technorama-ssc/you-decide/02 system/README.md

---
download: System Build Kit
slug: 999_system
download_slug: 999_sample_wall_connectors
---

# SYSTEM

All exhibits are based on a modular system. We have developed a range of connection solutions for 3D printing. The system is also compatible with the ITEM D30 system and can be expanded.

Here you can find information and materials about the construction system used throughout the exhibition.

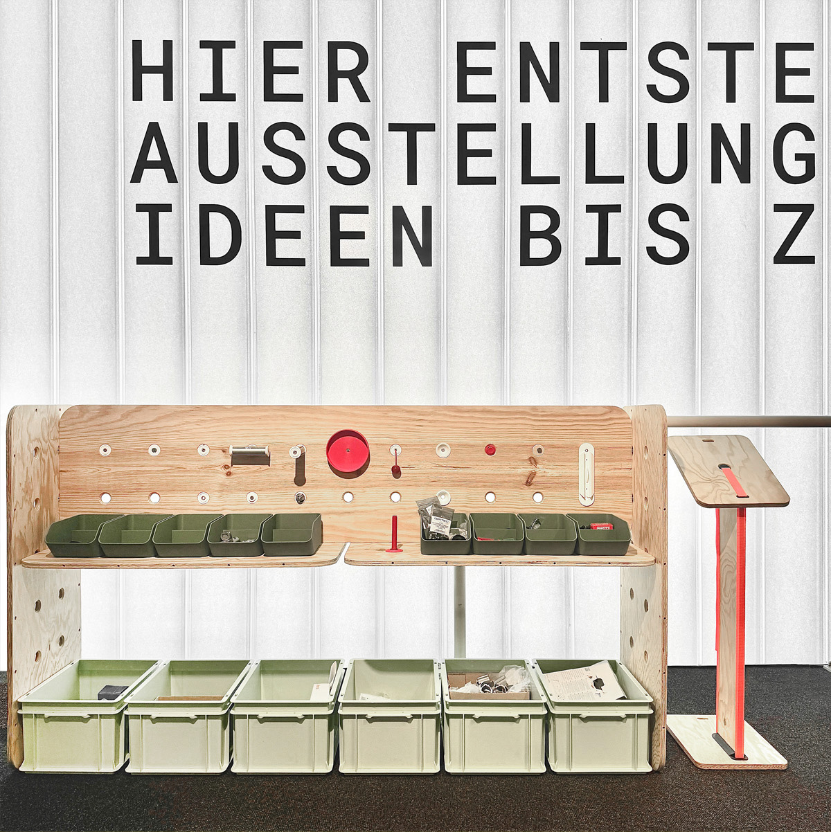
[picture p1: 02 system/999_system/04 media/You Decide_Sample Wall System Connectors .jpg]
SYSTEM


## Grid

The grid system is based on a modular design with a 157 mm grid and a 9 mm margin. The system panels are milled from 19 mm pine and feature Ø30 mm grid holes. They are compatible with the item D30 system for expansion.

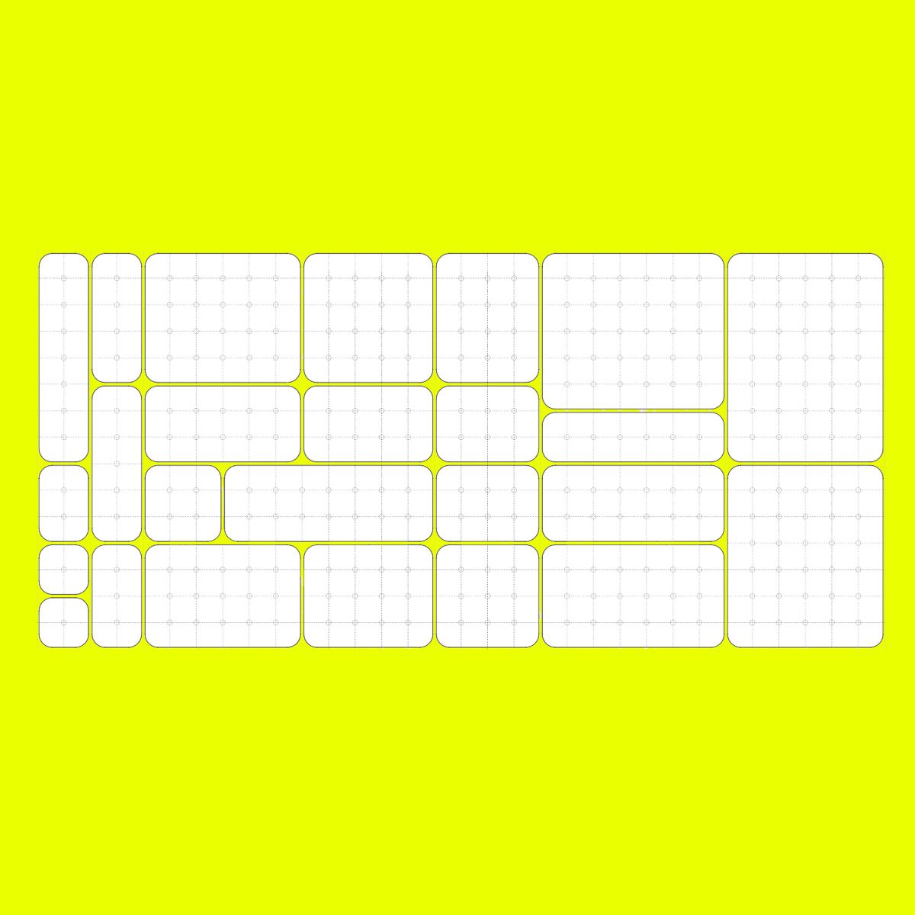
[picture p2: 02 system/999_system/04 media/You Decide_Grid System.jpg]
Grid


## Connectors

Main connector printed with: [Bambu Lab X1](https://eu.store.bambulab.com/de/products/pla-cf?id=43944001994971) <br>
INOX screw M6x35 mm available at: [Bossard](https://www.bossard.com/eshop/ch-de/schrauben/schrauben-mit-innenantrieb/senkschrauben-mit-innensechskant-ohne-schaft/p/2104/) <br>
M6 cross dowels type Q ⌀10x14 mm available at: [Rampa](https://www.rampa.com/eu/de/Onlineshop/Produkte/Quergewindebolzen/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)

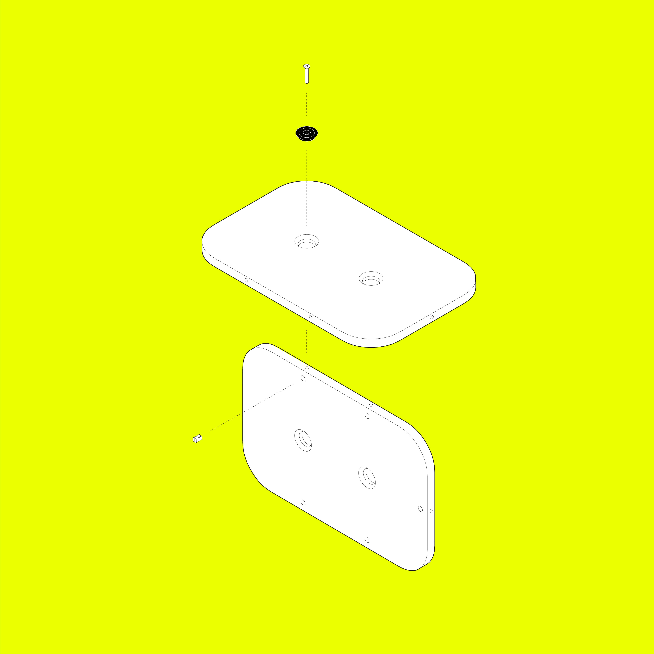
[picture p3: 02 system/999_system/04 media/You Decide_Main Connector_Technorama.jpg]
Connectors
