technorama-ssc/you-decide/you decide/hardware/README.md

# Hardware

Materials used for the exhibition labels and graphics:

- [Masking tape, writable, 15 mm x 20 m (Amazon)](https://www.amazon.de/dp/B09HZVJXY6)
- [Clairefontaine Trophée neon yellow paper, DIN A4 (papierdirekt.ch)](https://www.papierdirekt.ch/druckpapier/nach-format/druckpapiere-format-din-a3-297-x-420-mm/clairefontaine-troph-e-neon-din-a4-gelb.html)
