technorama-ssc/you-decide/01 exhibits/048_know yourself/README.md

---
id: "048"
download: Exhibit Build Kit
published: false
---

# know yourself

A vertical mirror, approximately 50 cm high and 90 cm wide, is placed on the floor against a wall. In front of it, a 5 CHF coin is glued to the floor.
When visitors bend down to pick up the coin, they realize that it is fixed in place and unexpectedly find themselves looking at their own reflection in the mirror.

## Findings

- Many visitors see the mirror before noticing the coin. 
- Visitors often smile or laugh when they realize the coin is glued to the floor. 
- Some visitors make repeated attempts to pick up the coin despite realizing it is fixed.
