technorama-ssc/you-decide/01 exhibits/000_do not press/README.md

---
id: "000"
download: Exhibit Build Kit
---

# Do not Press

A red button with the words “Do not press.” Behind it is a mechanism that you cannot see, but you can reach it. After pressing, a stuffed toy is destroyed.

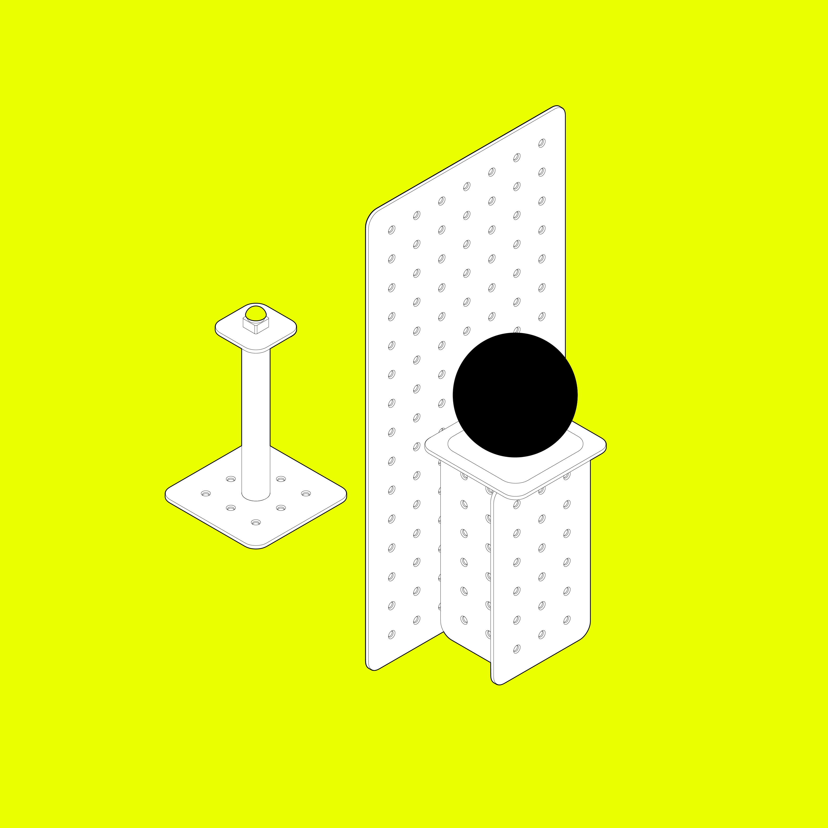
[picture p4: 01 exhibits/000_do not press/04 media/You Decide_Do not press_Technorama.jpg]
Do not Press


## Findings (draft)

...

## Libet Experiment (draft)

The brain “presses the button” before you believe you have made the decision.

In the Libet experiment, it was shown that the brain’s motor system begins preparing a movement before a person becomes consciously aware that they have decided to execute that movement immediately. The time gap is about 0.35 seconds, and the actual movement then occurs roughly another 0.2 seconds later.

[wikipedia.org/wiki/Libet-Experiment](https://de.wikipedia.org/wiki/Libet-Experiment)
