technorama-ssc/you-decide/01 exhibits/023_the coin/README.md

---
id: "023"
download: Exhibit Build Kit
---

# The Coin

Each week, we place a game coin in a jewelry case. Guests can choose whether to leave the coin or take it with them. If the coin remains until the end of the week, we donate CHF 50 to a charitable project – otherwise, we do not.

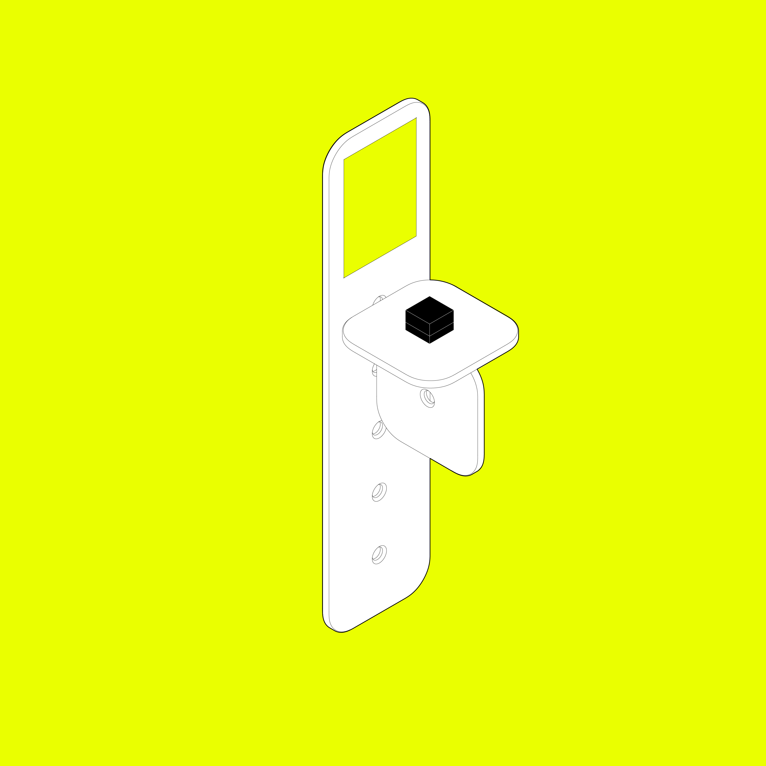
[picture p5: 01 exhibits/023_the coin/04 media/You Decide_The Coin_Technorama.jpg]
The Coin


## Findings

- The game coin usually is taken before the week is over.
- When the game coin is gone, a visitor will donate a real coin by placing it in the box.
- We collect the real coins for a charitable donation.
- We have discovered that whenever there is an empty box, visitors will again donate a real coin, some even hiding the coins under the velvet pad of the box.

## Konsequenzen (draft)

Das Exponat verbindet Fragen zur Entscheidungsfindung mit globaler Gesundheitspolitik. Tuberkulose zählt weltweit zu den häufigsten tödlichen Infektionskrankheiten. Jährlich sterben etwa 1,3 Millionen Menschen an der Erkrankung, hauptsächlich in Low-Income-Ländern (WHO-Daten 2024). Die Krankheit ist in vielen Fällen behandelbar, dennoch scheitert eine wirksame Bekämpfung oft an fehlendem Zugang zu Diagnostik, Medikamenten und stabilen Gesundheitssystemen.
50 Franken decken bereits die Kosten für Medikamente für mehrere Patientinnen und Patienten. Damit wird deutlich, wie konkrete finanzielle Beiträge unmittelbar in medizinische Versorgung übersetzt werden können. Aktuelle Daten und Berichte zu Tuberkulose bietet die World Health Organization (WHO) im jährlich erscheinenden „Global Tuberculosis Report“. 
Die Forschung zur Spendenpsychologie – etwa von den Nobelpreisträgern Abhijit V. Banerjee und Esther Duflo oder den Ökonomen Dean Karlan und Jacob Appel – hat gezeigt, dass auch relativ kleine Summen unter bestimmten Bedingungen eine messbare Wirkung entfalten können.

Literatur zur Einführung:
Ariely, Dan (2012): The Honest Truth About Dishonesty. Harper ; New York.
Banerjee, Abhijit V.; Duflo, Esther (2011): Poor Economics: A Radical Rethinking of the Way to Fight Global Poverty. PublicAffairs; New York.
Karlan, Dean; Appel, Jacob (2011): More Than Good Intentions: Improving the Ways the World's Poor Borrow, Save, Farm, Learn, and Stay Healthy. Dutton; New York.

Global Tuberculosis Report:
https://www.who.int/teams/global-tuberculosis-programme/tb-reports

## Moral (draft)

Philosophisch berührt das Exponat zentrale ethische Fragen der Verantwortung, des Unterlassens und der moralischen Pflicht. Wie weit reicht unsere Pflicht zu helfen? Und ist Unterlassen moralisch neutral oder bereits eine Entscheidung? Das Exponat macht damit ein klassisches Problem der Moralphilosophie sichtbar: Sind wir nur für das verantwortlich, was wir aktiv tun, oder auch für das, was wir bewusst nicht verhindern? In der Ethik wird beispielsweise diskutiert, ob Nicht-Handeln moralisch anders zu bewerten ist als aktives Handeln (Stichwort: „doing vs. allowing“). Ethische Diskussionen drehen sich auch um die Frage, ob Einzelne Vorteile geniessen, während andere die Last tragen.
Wichtige Beiträge zur ethischen Frage der Verantwortung, der Pflicht und des Spendens finden sich bei Peter Singer, insbesondere im Aufsatz „Famine, Affluence, and Morality“ sowie in seinem Buch „The Life You Can Save“. Singer argumentiert, dass Menschen moralisch verpflichtet sein könnten zu helfen, wenn sie dies ohne grossen eigenen Verlust tun können. Demgegenüber betonen andere Ansätze in der Ethik, etwa so genannte vertragstheoretische oder tugendethische Positionen, stärker die Rolle freiwilliger Solidarität und persönlicher Beziehungen bei moralischen Pflichten. Diese Ansätze sehen keine Pflicht zum Spenden.

Literatur zur Einführung:
Scanlon, Thomas M. (1998): What We Owe to Each Other. Harvard University Press; Cambridge.
Singer, Peter (1972): Famine, Affluence, and Morality. Philosophy and Public Affairs, 1(3): S. 229–243.
Singer, Peter (2009): The Life You Can Save. Random House; New York.

Überblick über moralische Dilemmata:
https://plato.stanford.edu/entries/moral-dilemmas/

Überblick über moralische Verantwortung:
https://plato.stanford.edu/entries/moral-responsibility/

## Partizipation (draft)

Das Exponat steht in der Tradition partizipativer und konzeptueller Kunst, bei der die Idee wichtiger ist als das materielle Objekt. Vergleichbare Ansätze finden sich bei Yoko Ono (Instructions for Paintings, 1960er Jahre) oder Felix Gonzalez-Torres (Arbeiten mit frei entnehmbaren Objekten, 1990er Jahre). In der Konzeptkunst wird das Publikum häufig Teil des Werks. Das Kunstwerk entsteht nicht allein durch ein Objekt, sondern durch eine gedankliche Anweisung und durch die Handlung der Betrachtenden.
Das Konzept des Exponats greift ausserdem auf Ideen der Entscheidungstheorie zurück, insbesondere die Nudge-Theorie von Richard Thaler und Cass Sunstein, bei der kleine Anreize Verhalten lenken sollen. Ein „Nudge“ verändert dabei nicht die Wahlmöglichkeiten selbst, sondern gestaltet die Entscheidungssituation so, dass ein bestimmtes Verhalten wahrscheinlicher wird.

Literatur zur Einführung:
Bishop, Claire (2012): Artificial Hells. Participatory Art and the Politics of Spectatorship. Verso; London u. New York.
Godfrey, Tony (1998): Conceptual Art. Phaidon; London.
Thaler, Richard H.; Sunstein, Cass R. (2008): Nudge: Improving Decisions about Health, Wealth, and Happiness. Yale University Press; New Haven.

Überblick zur Konzeptkunst:
https://www.tate.org.uk/art/art-terms/c/conceptual-art

Überblick über die Nudge Theory:
https://thedecisionlab.com/reference-guide/psychology/nudge-theory

## Verhaltensökonomie (draft)

Die Entscheidungssituation mit der Münze ähnelt klassischen Experimenten der Verhaltensökonomie wie dem „Public Goods Game“ oder dem „Prisoner’s Dilemma“. Diese Experimente untersuchen, unter welchen Bedingungen Menschen kooperieren oder egoistisch handeln. Das „Public Goods Game“ ist ein Experiment, bei dem mehrere Personen Geld in einen gemeinsamen Topf einzahlen können. Das Geld wird vermehrt und anschliessend gleichmäßig verteilt – auch an diejenigen, die nichts eingezahlt haben. Das „Prisoner’s Dilemma“ ist ein Gedankenexperiment aus der Spieltheorie: Zwei Personen können kooperieren oder sich gegenseitig verraten. Für jede Person ist Verrat aus Sicht des Eigeninteresses vorteilhaft, doch wenn beide verraten, stehen am Ende beide schlechter da, als wenn sie kooperiert hätten.
Wichtige Beiträge stammen von Ernst Fehr, Simon Gächter und Klaus Schmidt zur Kooperation und Bestrafung in Gruppen. Eine allgemeinverständliche Einführung bietet Daniel Kahneman in „Thinking, Fast and Slow“. Kahnemann zeigt, dass Menschen nicht rein rational im Sinne des Eigennutzes handeln, sondern stark von Fairnessvorstellungen, sozialen Normen und intuitiven Urteilen geleitet werden. Kooperation entsteht häufig dann, wenn Vertrauen, Gegenseitigkeit und die Erwartung sozialer Anerkennung eine Rolle spielen.

Literatur zur Einführung:
Fehr, Ernst; Gächter, Simon (2000): Cooperation and Punishment in Public Goods Experiments. American Economic Review, 90(4): S. 980–994.
Fehr, Ernst; Schmidt, Klaus (1999): A Theory of Fairness, Competition, and Cooperation. The Quarterly Journal of Economics, 114(3): S. 817–868.
Kahneman, Daniel (2011): Thinking, Fast and Slow. Farrar, Straus and Giroux; New York.

Überblick über das Prisoner’s Dilemma:
https://plato.stanford.edu/entries/prisoner-dilemma/
