technorama-ssc/you-decide/01 exhibits/041_bim bam bum/README.md

---
id: "041"
download: Exhibit Build Kit
---

# Bim Bam Bum

A bicycle pump stands in the room. Above it floats a red balloon. The balloon cannot burst. You pump towards a goal that is actually pointless – but you don’t know it.

How long will you keep pumping?

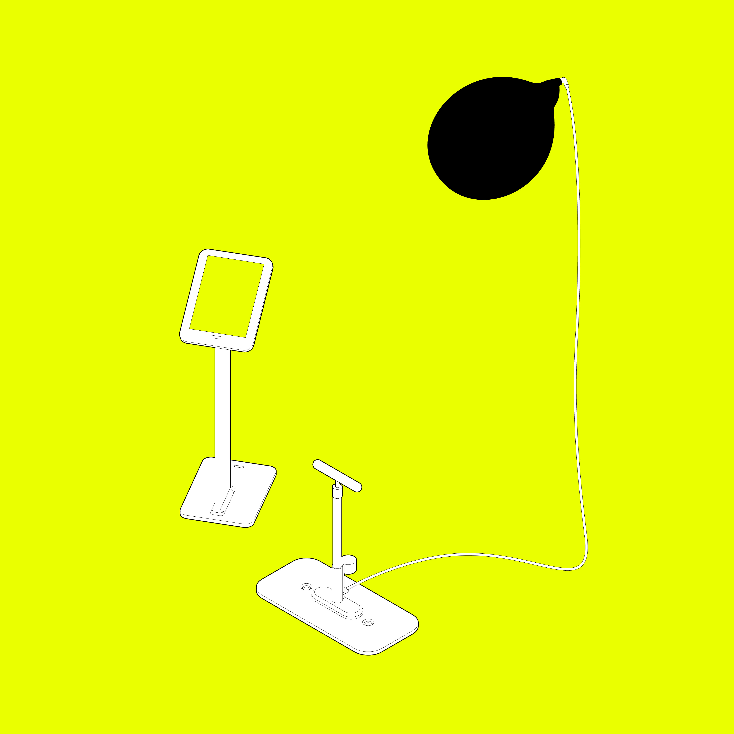
[picture p6: 01 exhibits/041_bim bam bum/04 media/You Decide_Bim Bam Bum_Technorama.jpg]
Bim Bam Bum


## Findings (draft)

...

## Libet Experiment (draft)

The brain “presses the button” before you believe you have made the decision.

In the Libet experiment, it was shown that the brain’s motor system begins preparing a movement before a person becomes consciously aware that they have decided to execute that movement immediately. The time gap is about 0.35 seconds, and the actual movement then occurs roughly another 0.2 seconds later.

[wikipedia.org/wiki/Libet-Experiment](https://de.wikipedia.org/wiki/Libet-Experiment)
