technorama-ssc/you-decide/01 exhibits/029_the tower/README.md

---
id: "029"
---

# the tower

On a table there are wooden cubes with magnets and screws. At the four corners there are supports with cords that allow 4 players to cooperate in building a tower.

## Findings

- Visitors enjoy playing and cooperate to build a tower.
- It can be frustrating when the cubes fall.
