technorama-ssc/you-decide/01 exhibits/023_the coin/04 media/Exhibit graphics_023_the coin.pdf

# Die Münze

# Rette ein Leben

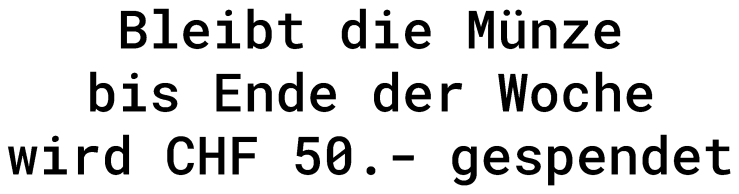
[picture p8: figure]
Bleibt die Münze bis Ende der Woche; wird CHF 50.; - gespendet

1,5 Mio. Menschen sterben jährlich weltweit an Tuberkulose (TB) | – das
entspricht etwa der Bevölkerung des Kanton Zürich. | Damit ist TB
die tödlichste Infektionskrankheit weltweit. Eine Spende von CHF 50. | -
ermöglicht Ärzte ohne Grenzen (MSF) die Behandlung einer Person
mit Tuberkulose | – eine Chance auf Heilung und Leben.

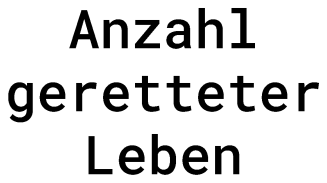
[picture p9: figure]
Anzahl geretteter Leben

1 Jahr / Kein Leben gerettet

31.08 - 06.09 2026 / Kein Leben gerettet
