technorama-ssc/you-decide/00 you decide/README.md

---
download: Exhibition Graphics Kit
slug: 998_exhibition
---

# YOU DECIDE

An exhibition about decisions—and how to save the world.

With over 20,000 decisions a day, we shape our future. Left or right, bike or bus, red or green gummy bear – do you know how you decide? In “You Decide”, you can experience yourself making decisions. How do you make decisions? What influences you? When do you take mental shortcuts?

This is the open-source platform for the “You Decide” exhibition. The exhibition—and this website—will never be finished—they keep changing with you.

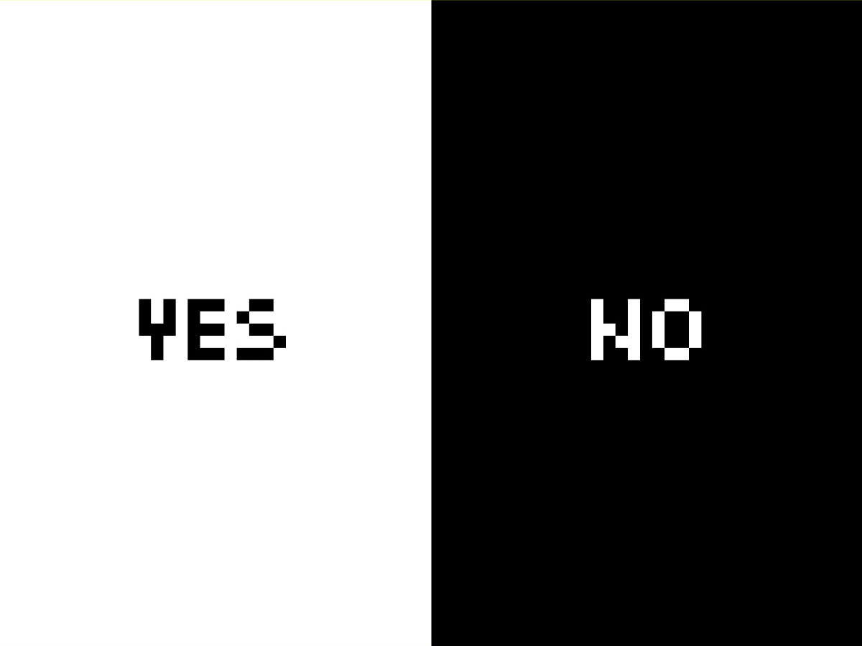
[picture p10: 00 you decide/998_exhibition/04 media/You Decide_Yes or No.jpg]
YOU DECIDE
