technorama-ssc/you-decide/01 exhibits/README.md

---
sections: "*"
---

# EXHIBITS

We continuously develop new ideas. In our exhibition, we test prototypes and keep improving them. Technorama guests are the test subjects. We want to prompt the question "How do I make decisions?"

Here we present a selection of our most advanced exhibits. You can download the parts lists and information for each exhibit here, rebuild them, or improve them.

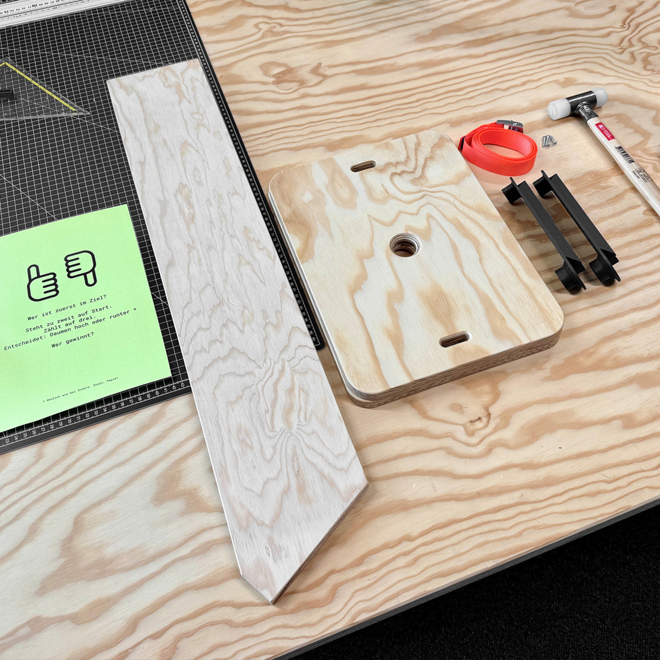
[picture p11: 01 exhibits/_media/youdecide_system_text stand.jpg]
EXHIBITS
