technorama-ssc/you-decide/01 exhibits/004_who's first on top/README.md

---
id: "004"
download: Exhibit Build Kit
---

# Who's First On Top

A two-player game that lets you experience the Prisoner’s Dilemma firsthand. Simple enough to become a break-time game for every school.

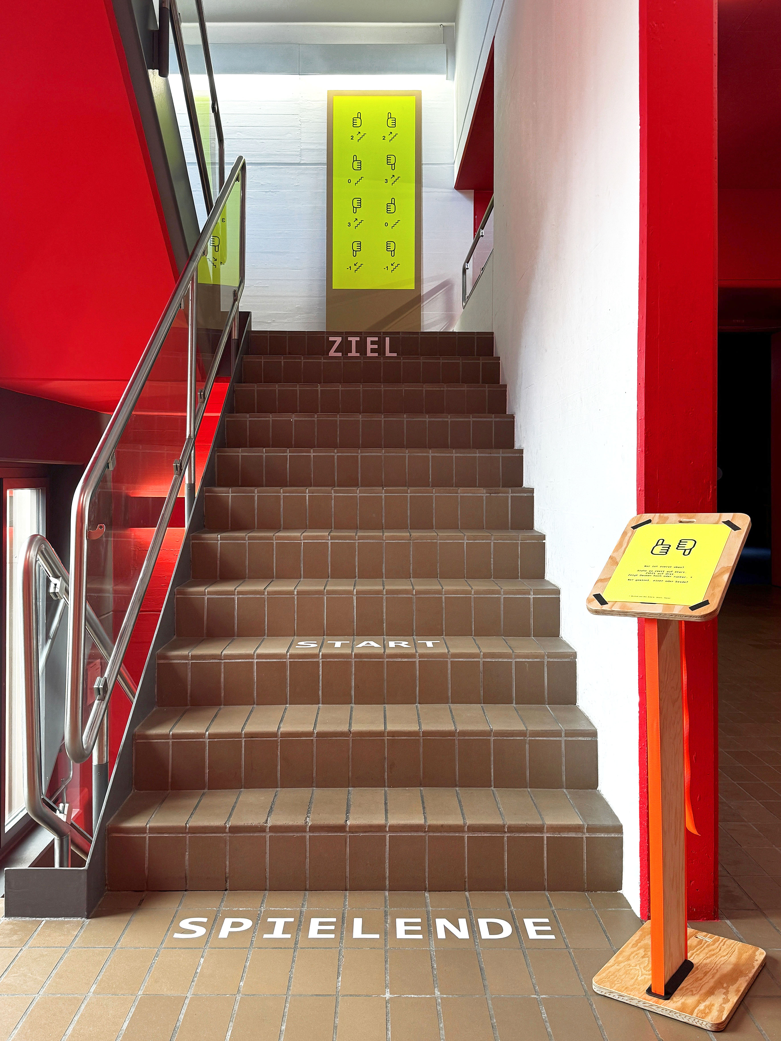
[picture p12: 01 exhibits/004_who's first on top/04 media/You Decide_Hwo's first on top_Technorama.jpg]
Who's First On Top


## Findings (draft)

...

## Background

The Prisoner’s Dilemma shows just how difficult decisions can become when personal interest and the common good come into conflict. What seems rational for one person can lead to a worse outcome for everyone. This paradox is what makes the dilemma so fascinating — and invites us to look at many everyday decisions and conflicts with others from a different perspective.

Film: [Game theorie](https://www.youtube.com/watch?v=mScpHTIi-kM)
