technorama-ssc/you-decide/01 exhibits/001_click click click/README.md

---
id: "001"
download: Exhibit Build Kit
---

# Click Click Click

Information to follow...

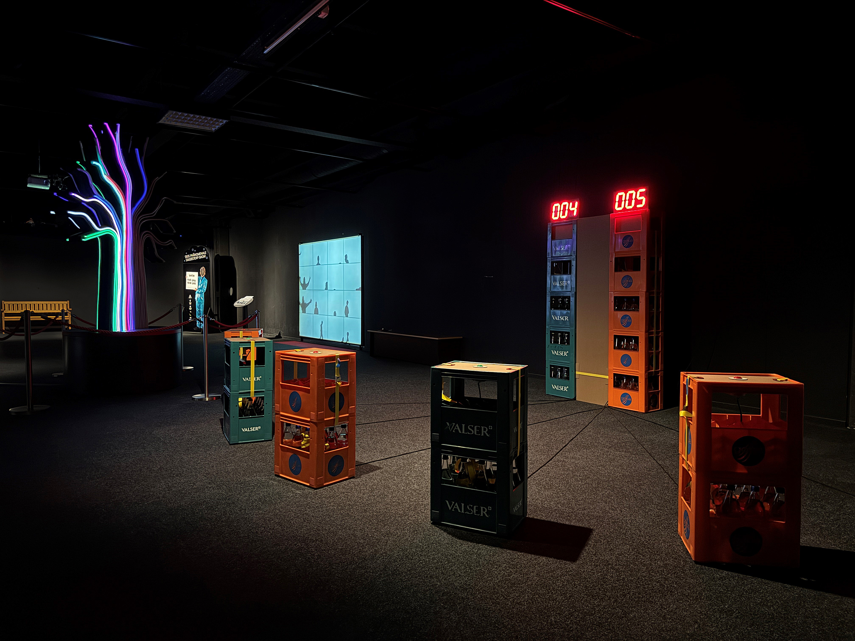
[picture p13: 01 exhibits/001_click click click/04 media/You Decide_Click Click Click_Technorama.jpg]
Click Click Click
