technorama-ssc/you-decide/01 exhibits/033_the circle/README.md

---
id: "033"
download: Exhibit Build Kit
---

# The Circle

The visitors decide together who may enter the circle. Once someone is inside, the rule is:

“No going back – convince another person to enter the circle, then you may leave.”

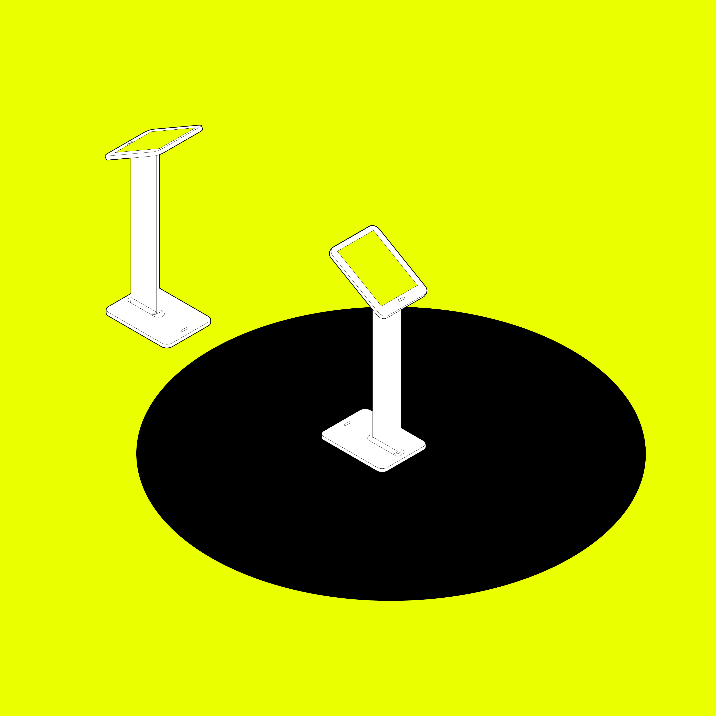
[picture p14: 01 exhibits/033_the circle/04 media/You Decide_The Circle_Technorama.jpg]
The Circle


## Findings (draft)

...

## Libet Experiment (draft)

The brain “presses the button” before you believe you have made the decision.

In the Libet experiment, it was shown that the brain’s motor system begins preparing a movement before a person becomes consciously aware that they have decided to execute that movement immediately. The time gap is about 0.35 seconds, and the actual movement then occurs roughly another 0.2 seconds later.

[wikipedia.org/wiki/Libet-Experiment](https://de.wikipedia.org/wiki/Libet-Experiment)
