technorama-ssc/you-decide/00 you decide/998_exhibition/01 docs/Graphic template A4.pptx

WIESO?

Deine Wahl
interesiert uns

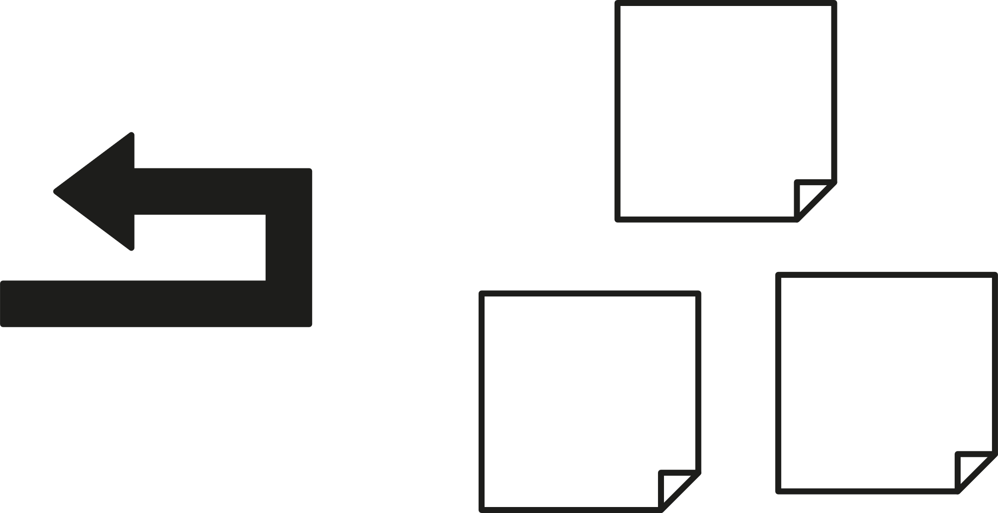
[picture p15: figure]

## Slide 2

Welche Schüssel gefällt dir besser?

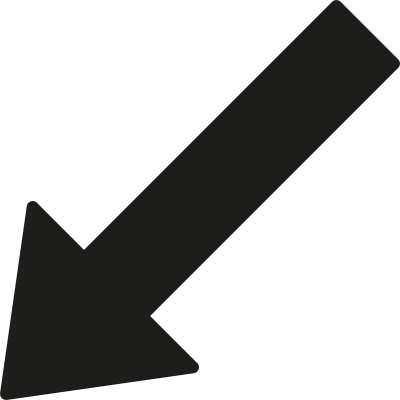
[picture p16: figure]
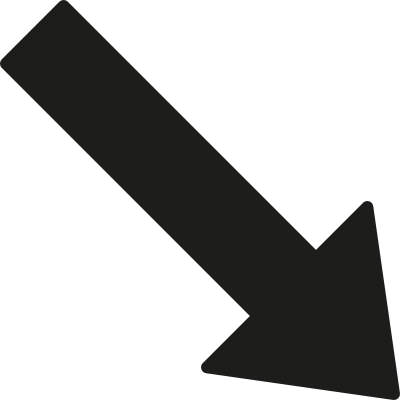
[picture p17: figure]

## Slide 3

Nicht
DrückeN

Gestalte dein Eigenes Plakat.
Rettet das Plüschtir!
