technorama-ssc/you-decide/01 exhibits/004_who's first on top/04 media/Exhibit graphics_004_who's first on top.pdf

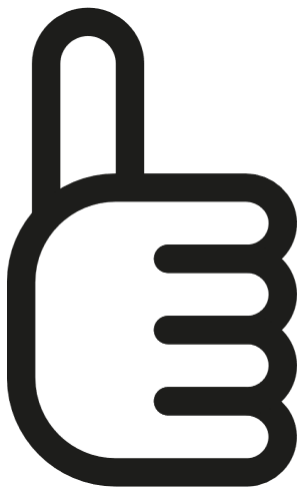
[picture p18: figure]
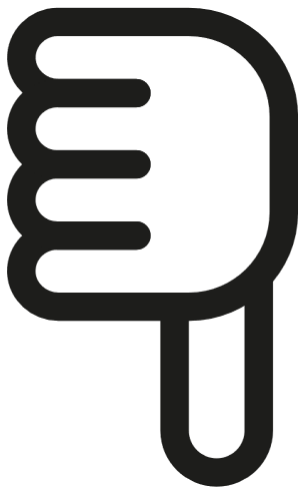
[picture p19: figure]

Wer ist zuerst oben?

* Ähnlich wie bei Schere, Stein, Papier | 160g

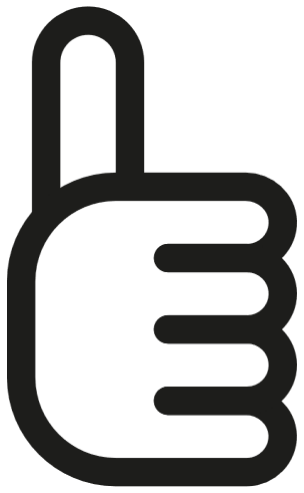
[picture p20: figure]
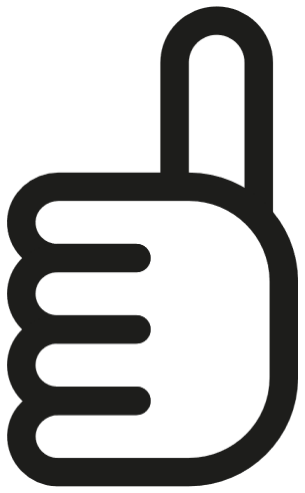
[picture p21: figure]
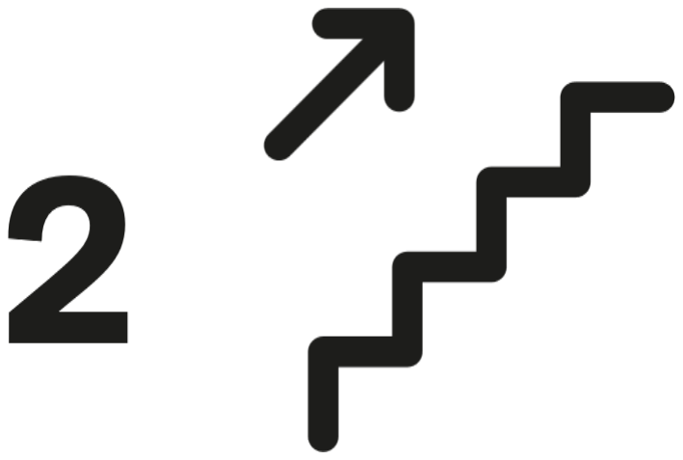
[picture p22: figure]
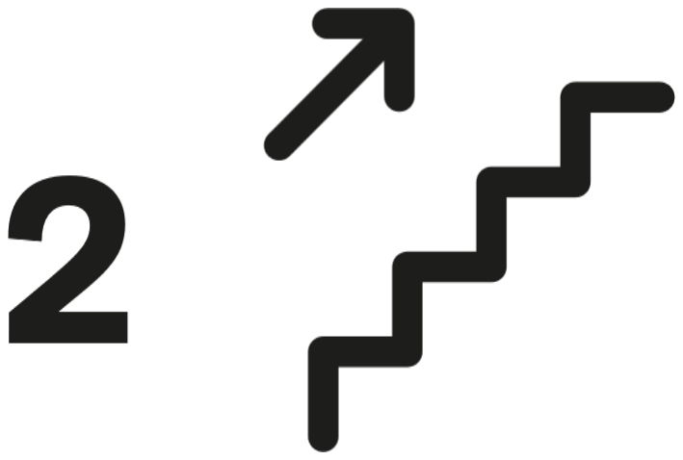
[picture p23: figure]

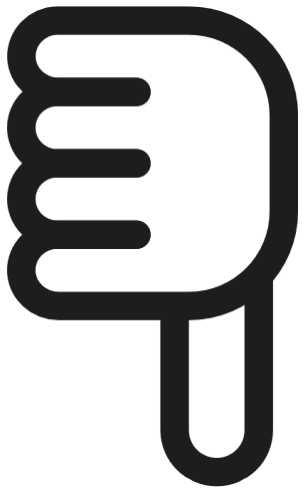
[picture p24: figure]
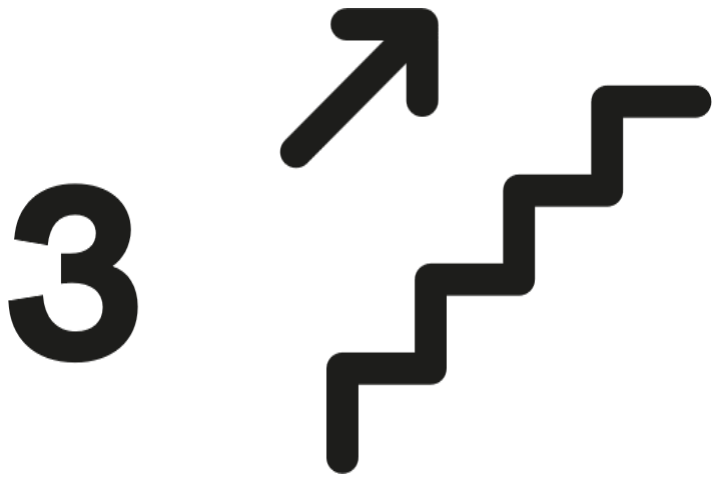
[picture p25: figure]
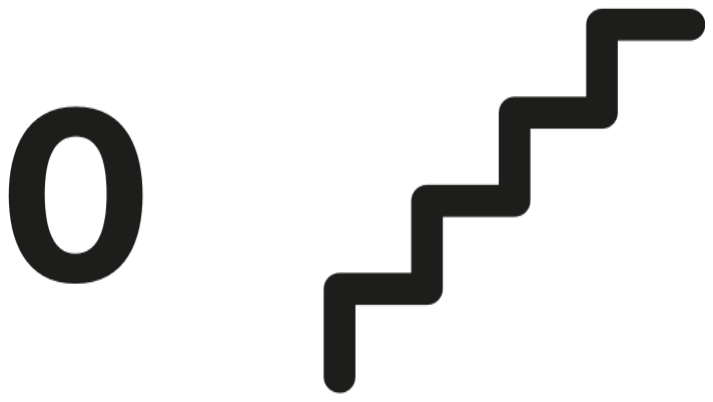
[picture p26: figure]

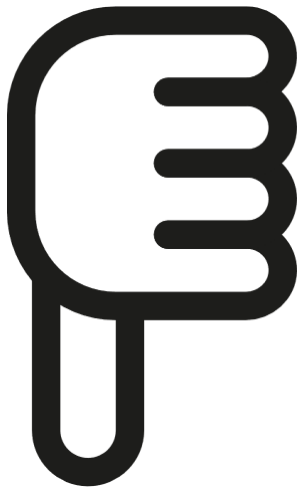
[picture p27: figure]
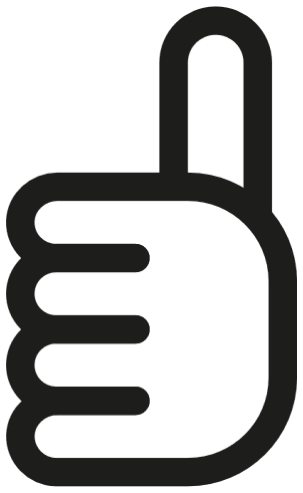
[picture p28: figure]
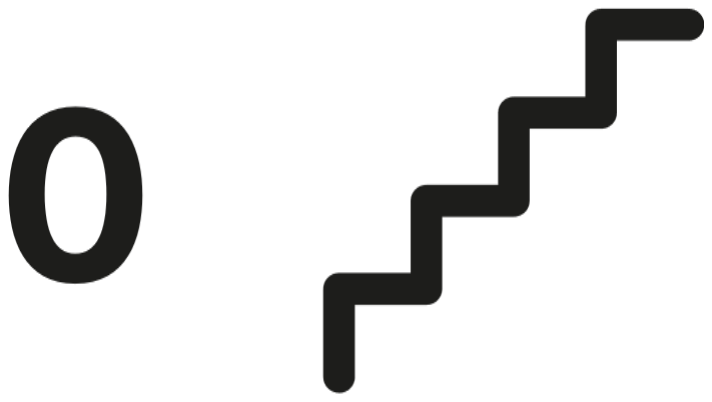
[picture p29: figure]

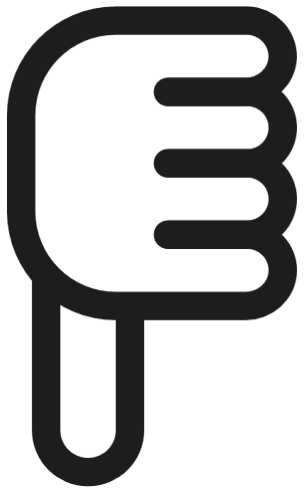
[picture p30: figure]
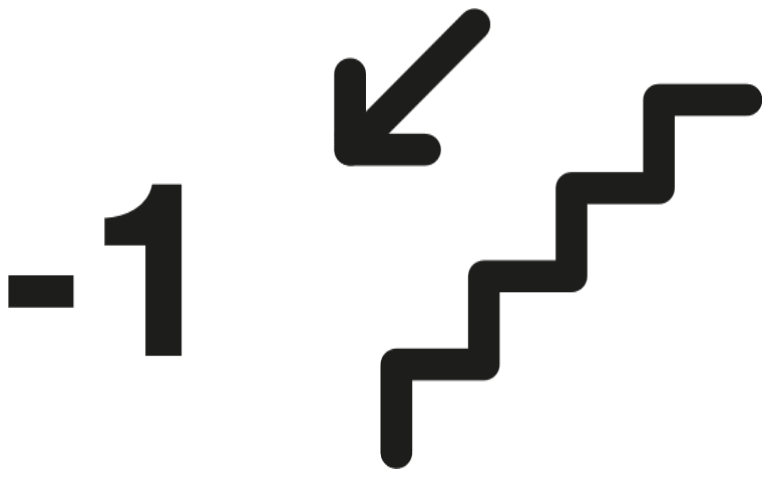
[picture p31: figure]
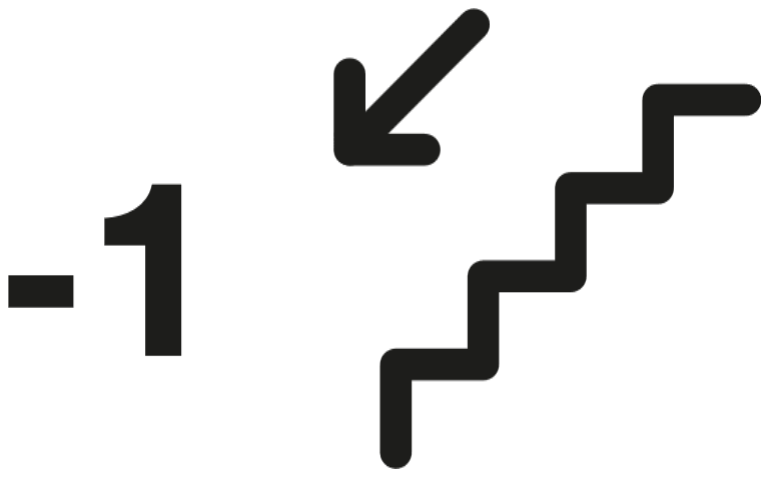
[picture p32: figure]
