technorama-ssc/you-decide/01 exhibits/033_the circle/04 media/Exhibit graphics_033_the circle.pdf

- Entscheidet –

# Der Kreis

# Kein

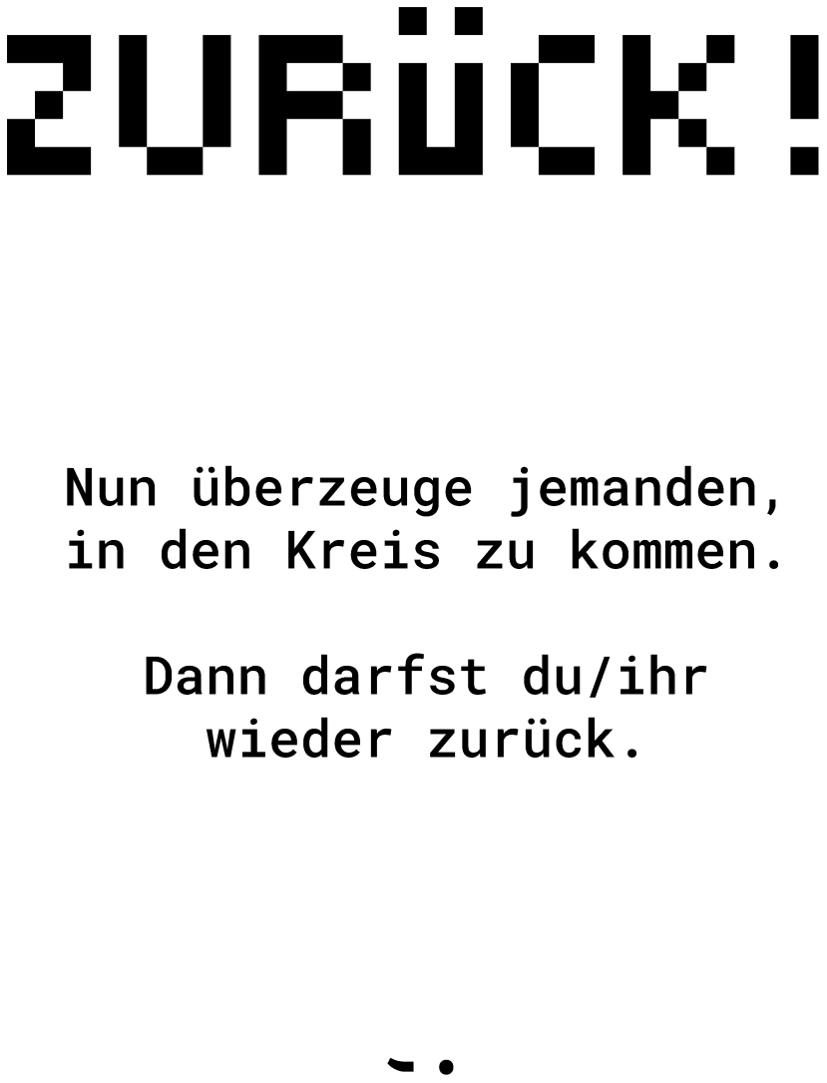
[picture p33: figure]
Nun überzeuge jemanden, in den Kreis zu kommen.; Zurück! ;)
