technorama-ssc/you-decide/01 exhibits/047_ball in a box/04 media/Exhibit graphics_047_ball in a box.pdf

Ziel: | Wo ist der Ball?
| Spielregeln

Zwei Personen (A + B) spielen gegeneinander.

Spieler A darf in seine Box schauen | – aber
nichts zeigen und die Box nicht bewegen.
Spieler B stellt Fragen | – Lügen ist erlaubt!
Entscheidet selbst, wann er/sie genug | weiss :
Boxen auf | – wer den Ball hat, gewinnt und
darf dem Verlierer eine Strafe auferlegen!

# BALL

# IN A

# BOX
