technorama-ssc/you-decide/00 you decide/998_exhibition/04 media/You Decide_Exhibit Graphics.jpg

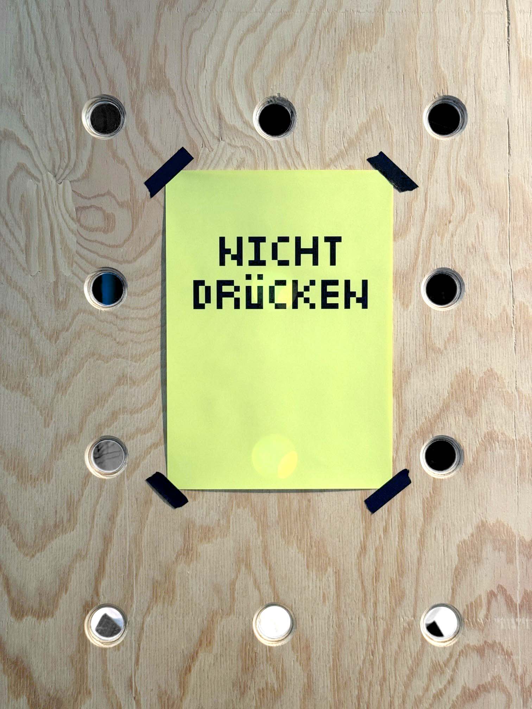
00 you decide/998_exhibition/04 media/You Decide_Exhibit Graphics.jpg
