technorama-ssc/you-decide/02 system/999_system/04 media/You Decide_Crate System Connector & Cover.jpg

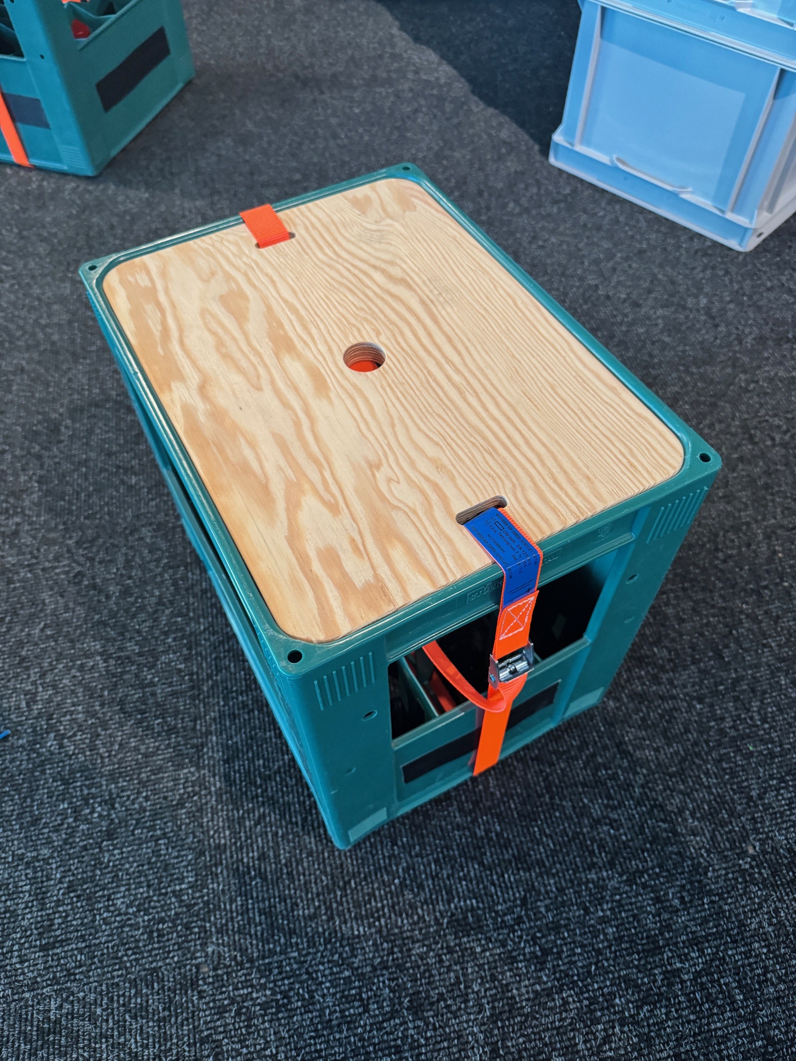
02 system/999_system/04 media/You Decide_Crate System Connector & Cover.jpg
