technorama-ssc/you-decide/02 system/999_system/04 media/You Decide_Plate System & Connector.jpg

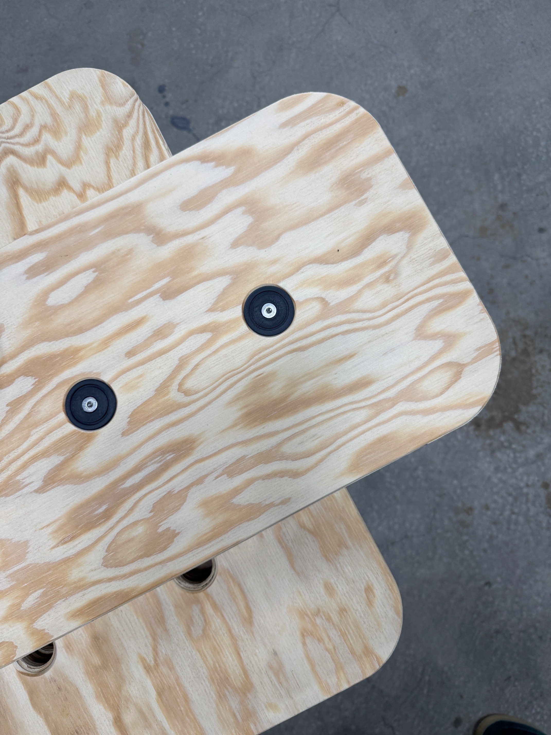
02 system/999_system/04 media/You Decide_Plate System & Connector.jpg
