technorama-ssc/you-decide/01 exhibits/000_do not press/03 hardware/Parts_000_Do not press.txt

PARTS

1 x Eaton DILEM-01-G (24VDC) Schütz 3 Schließer 4 kW 24 V/DC 9 A Passend für Marke (Relais)
https://www.conrad.ch

2 x RS PRO SPDT Timer Relay
https://docs.rs-online.com/6f1c/A700000008000892.pdf

1 x Buzzer
https://www.eaton.com/us/en-us/skuPage.229746.html

1 x 24 V Power Suply

1 x Mixer Setup / Makita Trimmer RT0702CJ
