technorama-ssc/you-decide/00 you decide/998_exhibition/03 hardware/Parts_998_Exhibition.txt

PARTS

Materials used for the exhibition labels and graphics:

Masking tape, writable, 15 mm x 20 m
https://www.amazon.de/dp/B09HZVJXY6

Clairefontaine Trophée neon yellow paper, DIN A4
https://www.papierdirekt.ch/druckpapier/nach-format/druckpapiere-format-din-a3-297-x-420-mm/clairefontaine-troph-e-neon-din-a4-gelb.html
