technorama-ssc/you-decide/02 system/999_system/03 hardware/Parts_999_System.txt

PARTS

PLATE SYSTEM

System plates based on the grid system: 18 mm Plywood Sperrapin, French maritime pine 
https://www.zehnder-handel.ch/customer/files/73/A---Sperrholz-2025-05-01.pdf

Main connector printed with: Bambu Lab X1 
https://eu.store.bambulab.com/de/products/pla-cf?id=43944001994971

INOX screw M6x35 mm available at: Bossard 
https://www.bossard.com/eshop/ch-de/schrauben/schrauben-mit-innenantrieb/senkschrauben-mit-innensechskant-ohne-schaft/p/2104/

M6 cross dowels type Q ⌀10x14 mm available at: Rampa
https://www.rampa.com/eu/de/Onlineshop/Produkte/Quergewindebolzen/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

System expansions: ITEM D30 
https://www.item24.com/de-de/rohr-d30-natur-62856

CRATE SYSTEM

Glass bottle crate 12 x 1,0 l / 400 x 300 x 384.5 mm: Stöckli 121tle Crate 
https://www.gebinde-technologie.ch/index.cfm?tem=1&spr=1&hpn=1&sbn=1&ssn=9

Cover (crate cover.stp): 18 mm Plywood Sperrapin, French maritime pine
https://www.zehnder-handel.ch/customer/files/73/A---Sperrholz-2025-05-01.pdf

Tie down with metal cam buckle / 25 mm x 5 m Mamutec
https://www.hasler.ch/de/Umreifungsgurte-MAMUTEC_MM1114-25050-08-8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
