technorama-ssc/you-decide/01 exhibits/001_click click click/03 hardware/Parts_001_Click Click Click.txt

PARTS

1 x Raspberry Pi Pico
https://www.raspberrypi.com/products/raspberry-pi-pico/

3 x Terminal Block Board for Raspberry Pi Pico
https://wiki.dfrobot.com/SKU_DFR0924_Terminal_Block_Board_for_Pico

3 x Red Push Button

3 x Green Push Button

6 x SparkFun 7-Segment Display - 6.5" (Red)
https://www.sparkfun.com/7-segment-display-6-5-red.html

6 x SparkFun Large Digit Driver
https://www.sparkfun.com/sparkfun-large-digit-driver.html

1 x 12 V Power Supply

Lots of cables...
