technorama-ssc/you-decide/01 exhibits/023_the coin/03 hardware/Parts_023_The Coin.txt

PARTS

1 x Jewelry Case 70x70x50mm
https://www.bijewa.ch/en/product/nero

1 x Silver play coin (each week)
