technorama-ssc/you-decide/01 exhibits/033_the circle/03 hardware/Parts_033_The Circle.txt

PARTS

2 x Reading stands

- 4 x Crate Cover
- 2 x Wooden part for a reading stand
- 2 x Cam buckle straps

https://www.hasler.ch/?srv=sortiment&pg=det&artid=100751303&markid=zurrgurt

1 x Painter’s tape for the circle
