technorama-ssc/you-decide/01 exhibits/041_bim bam bum/03 hardware/Parts_041_Bim Bam Bum.txt

PARTS

1 x Reading stands

- 2 x Crate Cover
- 1 x Wooden part for a reading stand
- 1 x Cam buckle straps

https://www.hasler.ch/?srv=sortiment&pg=det&artid=100751303&markid=zurrgurt

1 x Bicycle pump / Giyo
https://www.migros.ch/de/product/470241400000

1 x Plastic air hose with a valve Fitting

Red Balloons

Important: make a small hole at the top end of the tube (preferably using a heated needle) so that the balloon does not burst.
