technorama-ssc/you-decide/02 system/999_system/03 hardware/main connector.stp

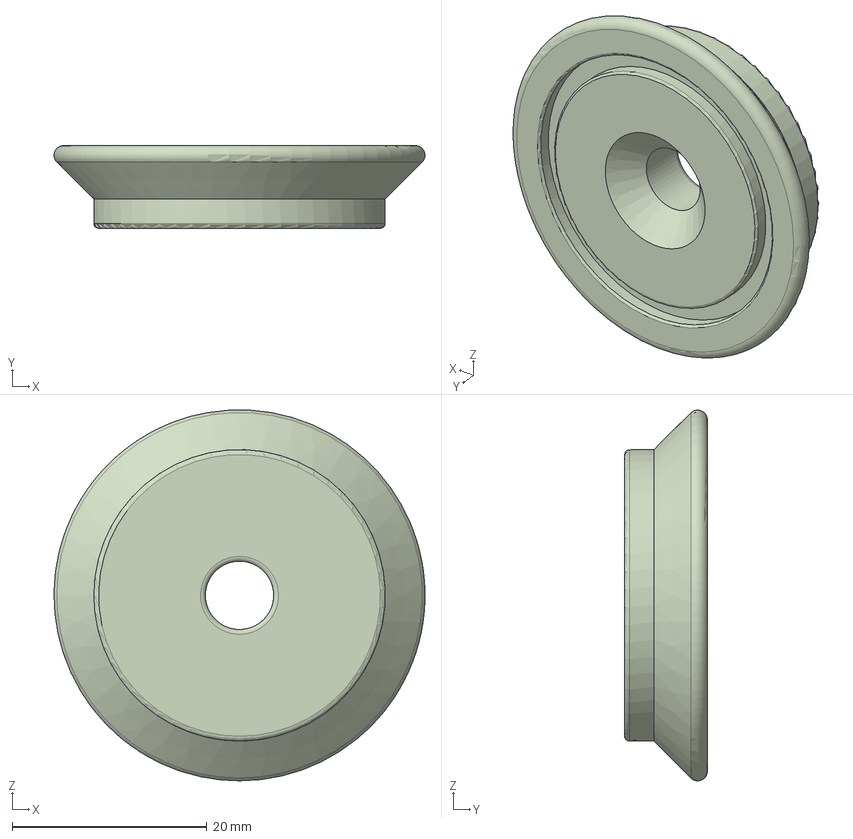
[picture p37: CAD file, 2026-09-02]
02 system/999_system/03 hardware/main connector.stp
38.1 x 8.50 x 38.0 mm
