technorama-ssc/you-decide/01 exhibits/001_click click click/03 hardware/001_click click click.stp

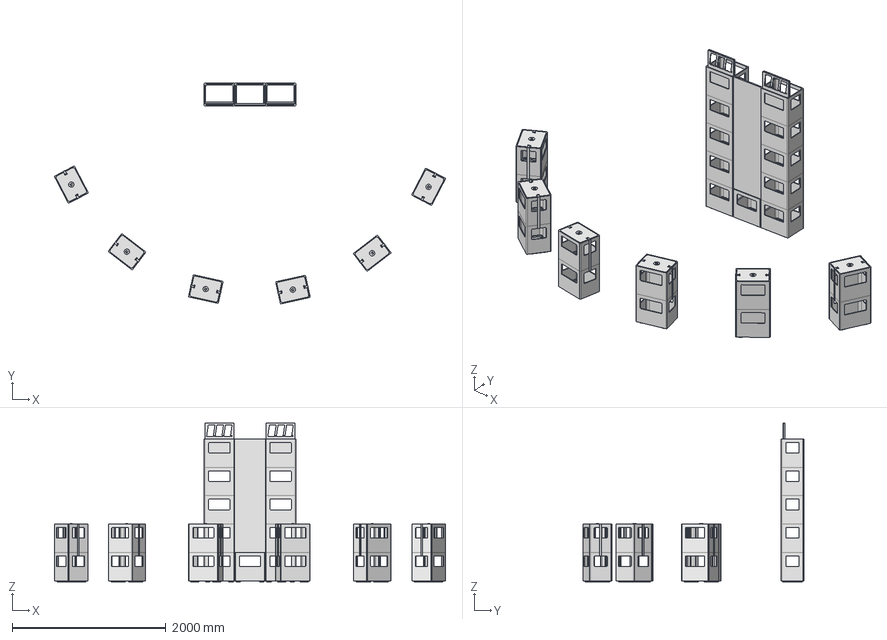
[picture p39: CAD file, 2026-09-08]
01 exhibits/001_click click click/03 hardware/001_click click click.stp
5085.2 x 2869.9 x 2065.3 mm
241209_Harasse_001 x 23
241127_001_Grundplatte Nummer Anzeige x 2
241127_001_Grundplatte Nummer Anzeige_Front x 2
260528_Harassen Systemplatte_Valser x 6
260325_Spanngurte -fach x 6
260325_Druckknopf x 6
260325_Click Click Cklick Kartonplatte
260211_A4 Papier
