technorama-ssc/you-decide/01 exhibits/023_the coin/03 hardware/023_the coin.stp

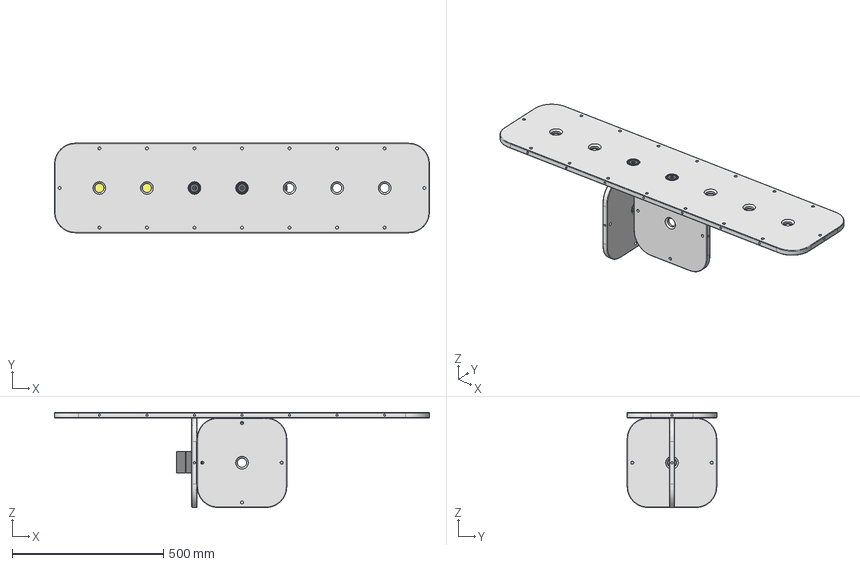
[picture p40: CAD file, 2026-09-09]
01 exhibits/023_the coin/03 hardware/023_the coin.stp
1238.0 x 296.0 x 314.0 mm
7x15_1238x2494_006
7x15_1238x2494_006_1 x 2
260211_Schmucketui
260211_A4 Papier
Verbinder_006_Kabel x 3
ISO 10642 - M6 x 35 x 3
