technorama-ssc/you-decide/01 exhibits/033_the circle/03 hardware/033_the circle.stp

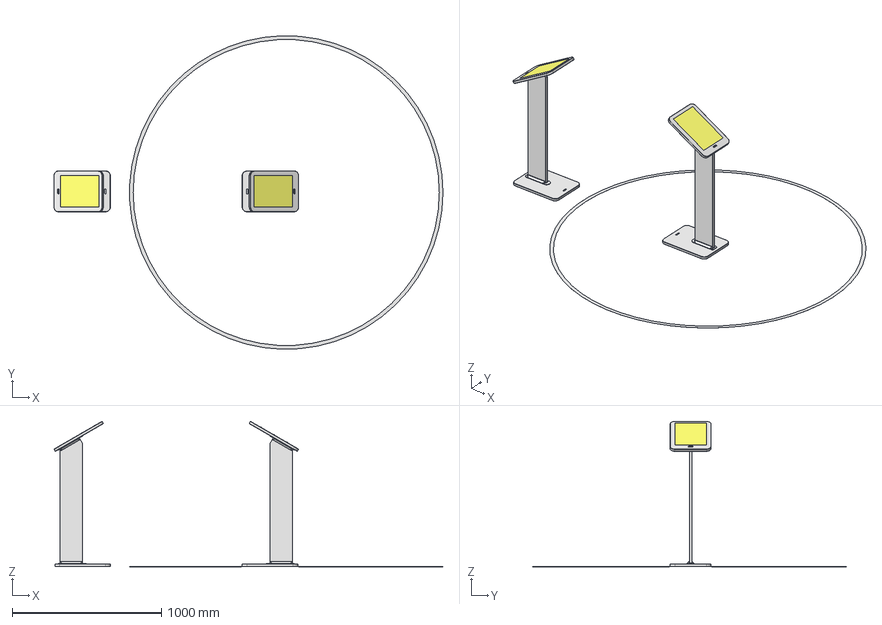
[picture p41: CAD file, 2026-09-08]
01 exhibits/033_the circle/03 hardware/033_the circle.stp
2605.6 x 2099.1 x 972.7 mm
250908_Abdeckplatte Druckknopf_Holz_Goba x 4
250819_Textständer verbinder_002 x 4
250818_Ständer Textständer x 2
260211_A4 Papier x 2
