technorama-ssc/you-decide/01 exhibits/041_bim bam bum/03 hardware/041_bim bam bum.stp

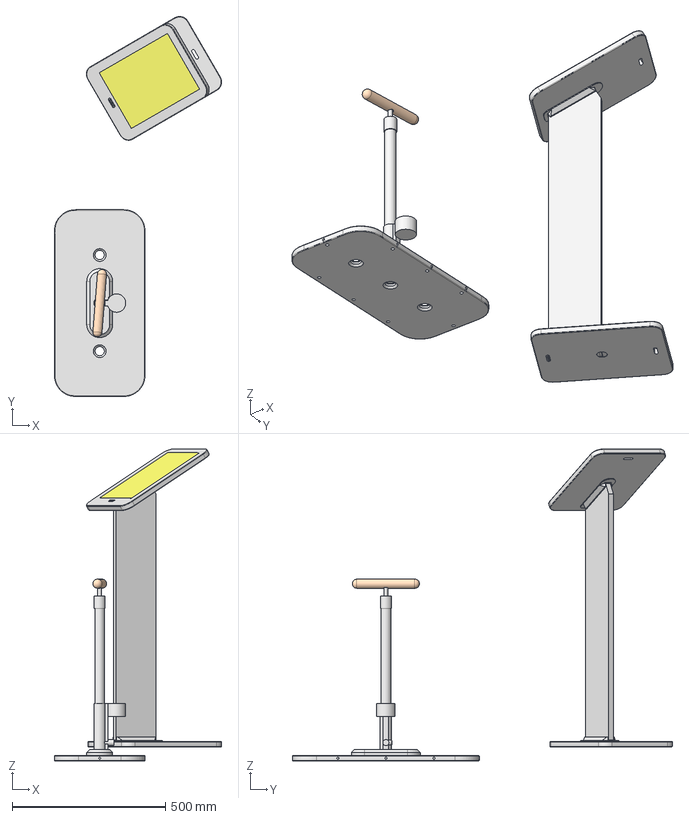
[picture p42: CAD file, 2026-09-08]
01 exhibits/041_bim bam bum/03 hardware/041_bim bam bum.stp
546.1 x 1241.0 x 1018.8 mm
260326_Fahradpumpe
260901_Silca Griff
7x15_1238x2494_006
250908_Abdeckplatte Druckknopf_Holz_Goba x 2
250819_Textständer verbinder_002 x 2
250818_Ständer Textständer
260211_A4 Papier
