technorama-ssc/you-decide/02 system/999_system/03 hardware/999_system.stp

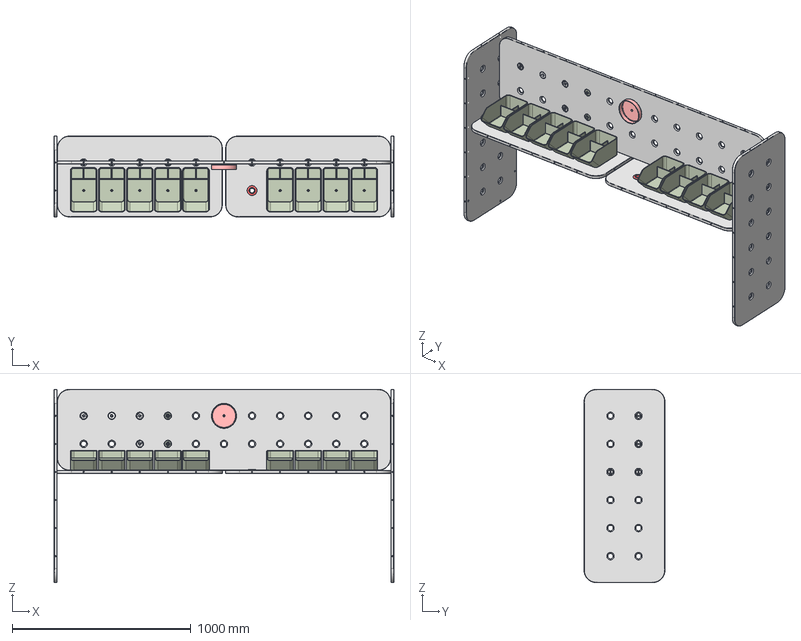
[picture p43: CAD file, 2026-09-30]
02 system/999_system/03 hardware/999_system.stp
1902.0 x 453.0 x 1081.0 mm
7x15_1238x2494_006
7x15_1238x2494_006_1 x 2
7x15_1238x2494_006_2 x 2
251006_Sichtlagerkasten x 9
Verbinder_006_Kabel
250430_Ampel_LED Verbinder
Verbinder_006_Kabel_1
Verbinder Rolle_001
Verbinder_006_Item Klemmscheibe x 2
Verbinder_006_Schale
Verbinder_006_Edding BTK25 refill ink
