technorama-ssc/you-decide/02 system/999_system/03 hardware/drilling jig plate system.stp

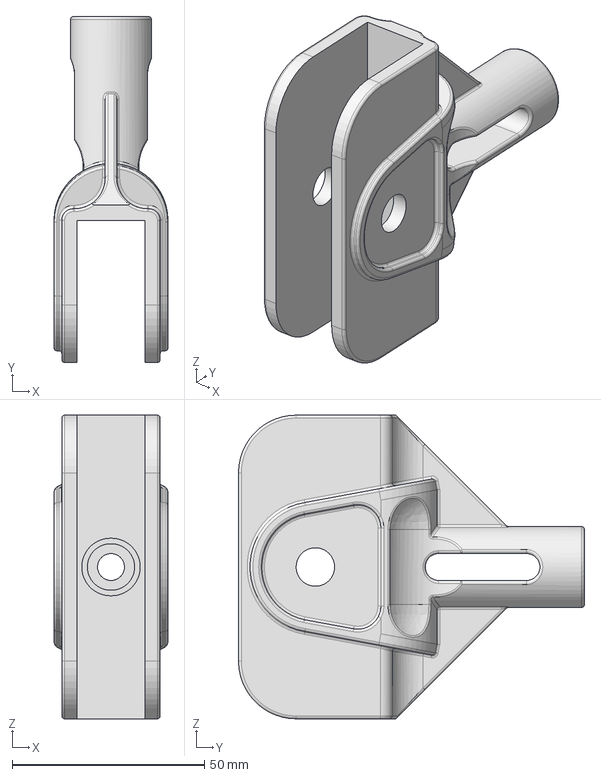
[picture p44: CAD file, 2026-09-02]
02 system/999_system/03 hardware/drilling jig plate system.stp
29.6 x 90.0 x 79.0 mm
