technorama-ssc/you-decide/02 system/999_system/03 hardware/system plate 240 x 120.stp

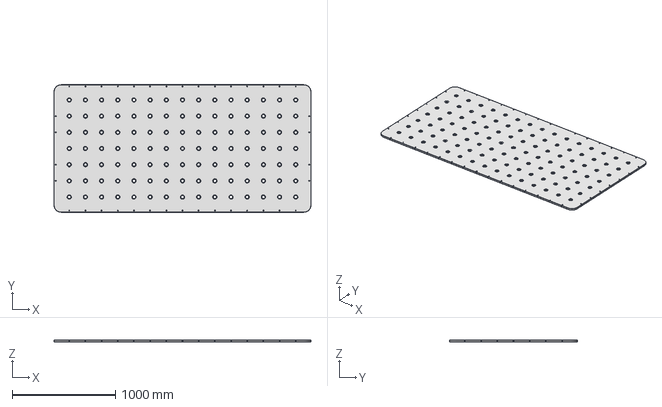
[picture p45: CAD file, 2026-09-02]
02 system/999_system/03 hardware/system plate 240 x 120.stp
2494.0 x 1238.0 x 18.0 mm
