technorama-ssc/you-decide/02 system/999_system/03 hardware/crate cover.stp

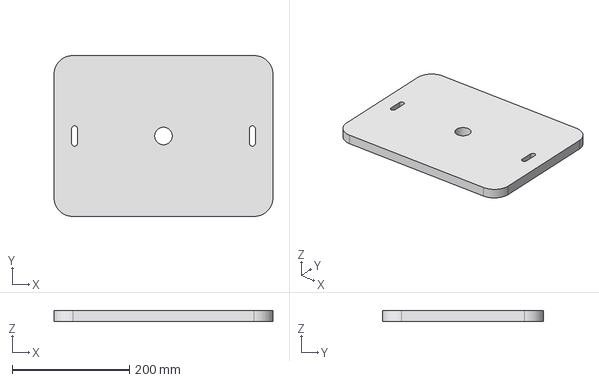
[picture p46: CAD file, 2026-04-13]
02 system/999_system/03 hardware/crate cover.stp
373.0 x 274.0 x 18.0 mm
