technorama-ssc/you-decide/01 exhibits/031_the builder and the observer/README.md

---
id: "031"
---

# the builder and the observer

Wooden blocks are placed on a table so that visitors can build a tower. A rope is attached to the table, runs along the ceiling, and then hangs down approximately four meters away. Pulling the rope downward lifts the table, causing the structure built on it to collapse.

## Findings

- Visitors often build a tower and then deliberately make it collapse by pulling the rope. 
- Younger visitors particularly enjoy destroying towers. regardless of whether they were built by strangers or by family members.
- Visitors pull the rope even when no tower has been built. 
- Many visitors pull the rope directly from the table.
