technorama-ssc/you-decide/01 exhibits/041_bim bam bum/03 hardware/Wooden part for a reading stand.pdf

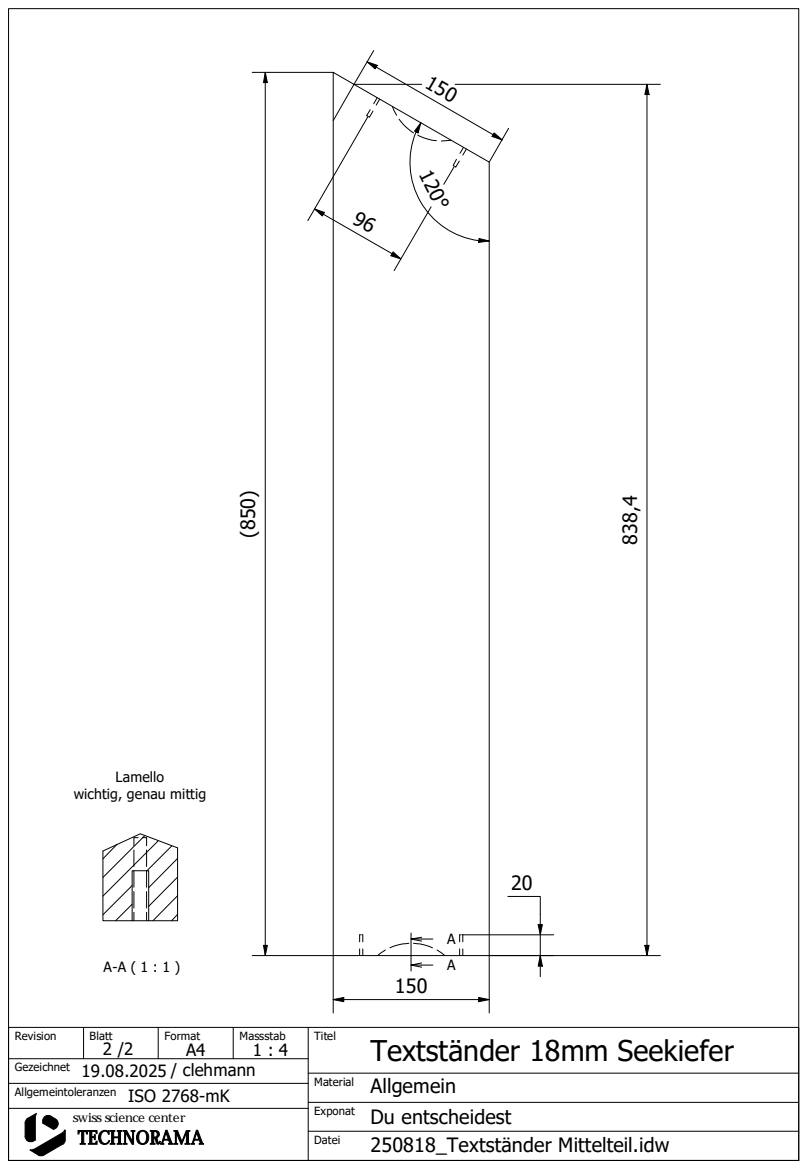
[picture p47: page 1]
/ clehmann; 250818_Textständer Mittelteil.idw; Du entscheidest; Textständer 18mm Seekiefer; ISO 2768-mK

wichtig, genau mittig

swiss science center
TECHNORAMA
