technorama-ssc/you-decide/02 system/999_system/04 media/You Decide_Core System.pdf

2025

## You Decide

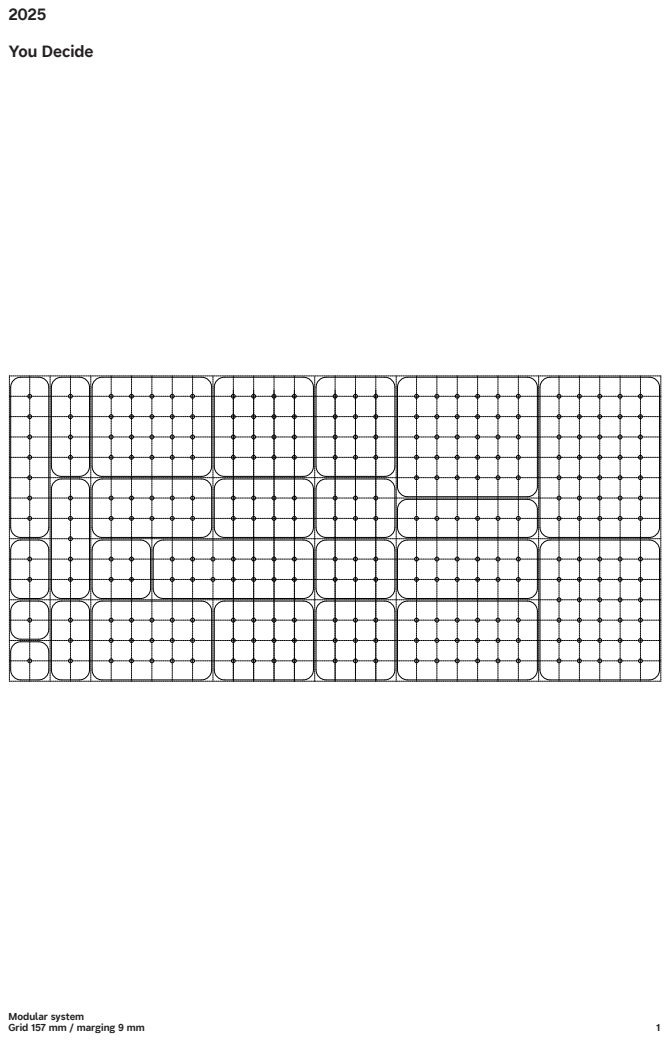
[picture p48: page 1]
Modular system; Grid 157 mm / marging 9 mm

2025

## You Decide

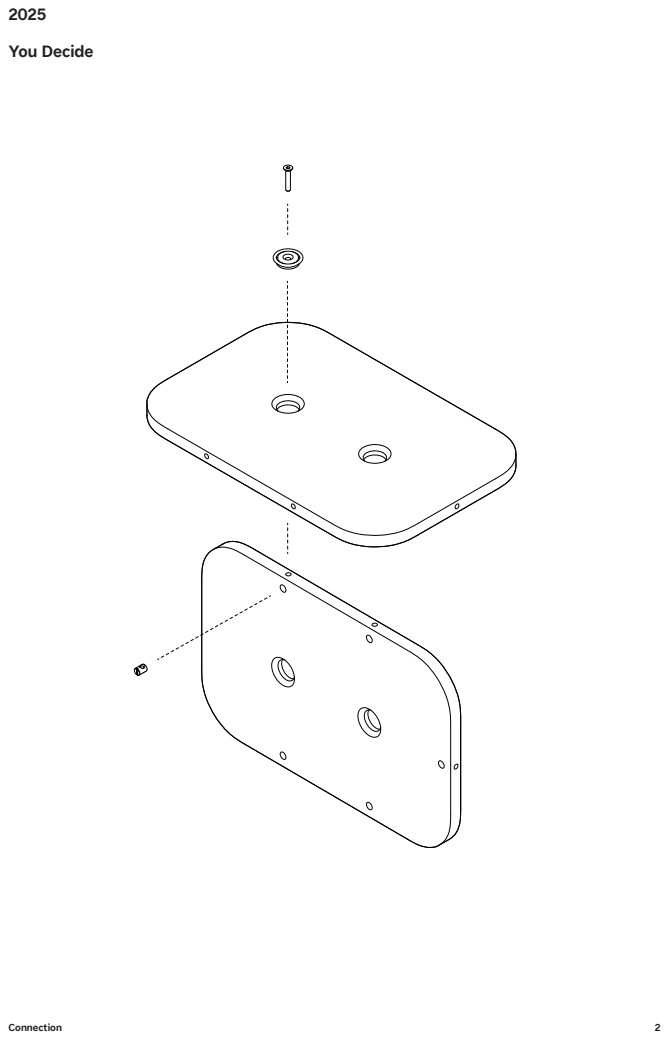
[picture p49: page 2]
Connection
