technorama-ssc/you-decide/01 exhibits/000_do not press/02 code/000_do not press_schematic.pdf

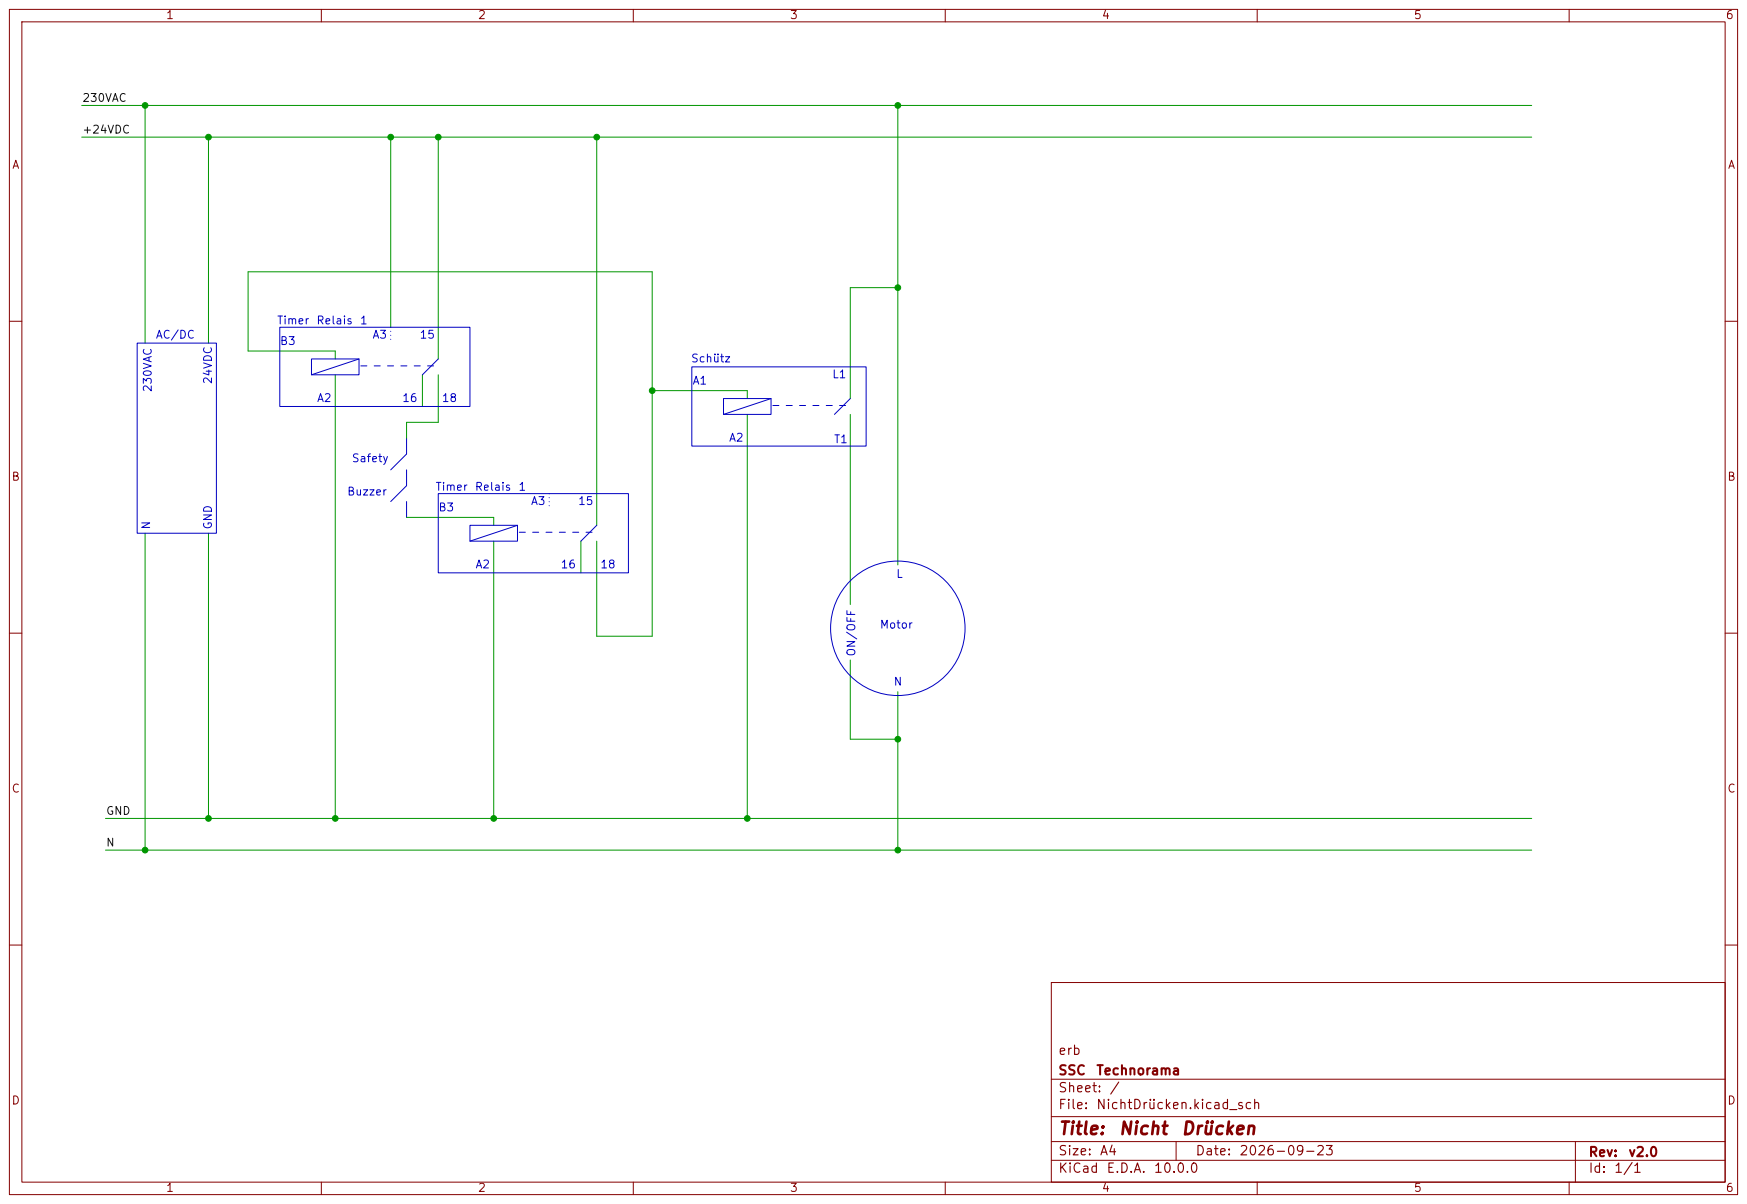
[picture p50: page 1]

Size: A4 | Rev: v2.0
