technorama-ssc/you-decide/01 exhibits/traffic light entrance/03 hardware/202505_schematic traficlight.pdf

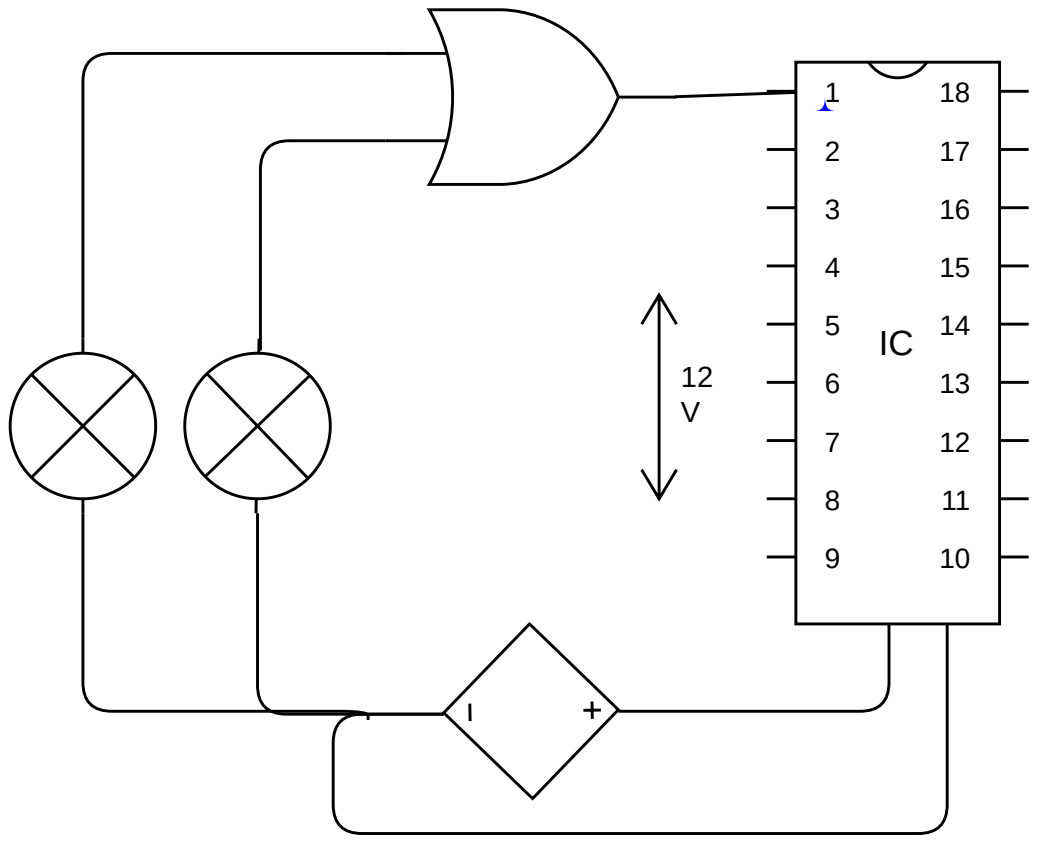
[picture p51: page 1]
