technorama-ssc/you-decide/(commit log)

2026-02-16 Update styles and content
    [do not press_assembly.stp]
2026-02-16 Filter dev_server.py to show only numbered folders
    [crate cover.stp, do not press_assembly.stp, drilling jig plate system.stp, main connector.stp, system plate 240 x 120.stp]
2026-02-16 bitte commiten und pushen
2026-02-16 Use subfolder styling for nested subsections (Libet Experiment like GRID/CONNECTORS)
2026-02-17 Restructure: Update exhibits structure and add subsections to The Coin
    [click click click_assembly.stp, traffif light_assembly.stp]
2026-02-19 Add prototype workshop docs
2026-03-05 Remove prototype workshop and tighten folder visibility
2026-03-25 Fix: Filter out images starting with numbers and remove broken link reference
2026-04-13 Commit all current changes
2026-04-13 Commit current README updates
2026-04-13 Update connector image for 02 system/01 connectors
2026-04-13 Update edited connector image with same filename
2026-04-13 Add ZIP files to exhibits and update download labels to Exhibit Build Kit
    [000_Do not press.stp, 023_The Coin.stp, 033_The Circle.stp, 041_Bim Bam Bum.stp, crate cover.stp]
2026-06-16 feat(content): publish 3-digit exhibits without images; adjust client-side filter
2026-06-16 build_static: strip UTF-8 BOM from README first line
2026-06-16 Regenerate content.json after BOM fix
2026-06-16 Fix image path case for Bim Bam Bum
2026-06-18 chore: save current workspace state
2026-08-25 Replace SYSTEM connector image and add exhibits text image
2026-08-25 Add exhibits text image; replace and cleanup SYSTEM connector image
2026-09-02 Restore lost content and move to a content-first tree
    - Restore code, hardware, media and system files deleted in the
    Feb 2026 restructure (from commit 94014c3) and the newer, never
    committed versions from the local SharePoint checkout
    (do_not_press.py, click_click_click.py, Core System PDF, renders).
    - Drop numbered folder prefixes; exhibits live under exhibits/<name>
    with docs/, code/, hardware/, media/ subfolders.
    - Remove committed zips and the duplicated content_* folders
    (verified byte-identical before deletion).
    - Move the website into .site/ and delete the duplicate root copies
    (the root script.js/style.css were UTF-16 re-encodes, the root
    content.json was invalid JSON)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
    [000_Do not press.stp, 023_The Coin.stp, 033_The Circle.stp, 041_Bim Bam Bum.stp, click click click_assembly.stp, crate cover.stp, do not press_assembly.stp, drilling jig plate system.stp]
2026-09-02 Keep folder numbering, inline section text into youdecide.json
    - Restore the numbered prefixes (00 you decide, 01 exhibits/NNN_name,
    01 docs/02 code/03 hardware/04 media, 02 system/00 grid system ...).
    The website ignores them; they are for people browsing the repo.
    - Section texts now live in the content field of youdecide.json
    (string or list of lines); the README.md copies are removed.
    build.py still accepts text: <file> as an alternative.
    - Restored exhibits trimmed to code, README and parts files; the old
    assembly STPs and photos of Do Not Press, Click Click Click and
    Traffic Light Entrance are left in git history only.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
    [000_Do not press.stp, 023_The Coin.stp, 033_The Circle.stp, 041_Bim Bam Bum.stp, click click click_assembly.stp, crate cover.stp, do not press_assembly.stp, drilling jig plate system.stp]
2026-09-02 Remove the unused connector render and plate connector photo
2026-09-02 Restore the connector render and plate connector photo
2026-09-02 Connectors media: keep the reference photos, drop the render
    Move the two system reference photos from 03 library into
    02 system/01 connectors/media and remove the unused render and plate
    connector photo again.
2026-09-02 Website: keyboard access and a mobile layout
    - Section and exhibit titles contain real buttons with aria-expanded
    and aria-controls; panels are labelled regions; nested titles are h3.
    Visible focus ring; download links open with rel=noopener.
    - Images carry their alt text from the README into the page.
    - Viewport meta is back, with breakpoints below 900 px: fluid title
    size, narrower gutters, images never wider than the screen.
    - .site/TODO.md lists the remaining ideas.
2026-09-03 Match current website visual layout
2026-09-03 Update system connectors image
2026-09-07 Update 023 The Coin STEP export
    [023_the coin.stp]
2026-09-07 Update generated exhibit STEP files
    [023_the coin.stp]
2026-09-07 Revise section title and add tuberculosis context
    Updated section title and provided information on tuberculosis and its treatment costs.
2026-09-07 Revise section title and enhance content on donations
    Updated section title and added context about tuberculosis and donation impact.
2026-09-08 Update generated exhibit STEP file 023
    [023_the coin.stp]
2026-09-08 Update generated exhibit STEP file 000
    [000_do not press.stp]
2026-09-08 Update generated exhibit STEP file 033
    [033_the circle.stp]
2026-09-08 Update generated exhibit STEP file 041
    [041_bim bam bum.stp]
2026-09-08 Update generated exhibit STEP file 001
    [001_click click click.stp]
2026-09-17 Restructure 02 system like an exhibit (999_system folder)
    [crate cover.stp, drilling jig plate system.stp, main connector.stp, system plate 240 x 120.stp]
2026-09-29 Add do not press schematic PDF
2026-09-30 Update generated STEP file 999
    [999_system.stp]
